akornsys-rdi/acoustic-impact-ball/doc/qrurl.png

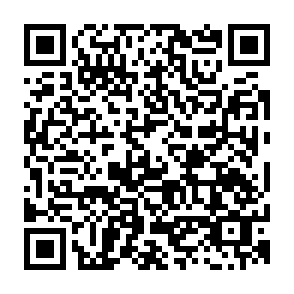
doc/qrurl.png
