akornsys-rdi/acoustic-impact-ball/doc/UN3481.png

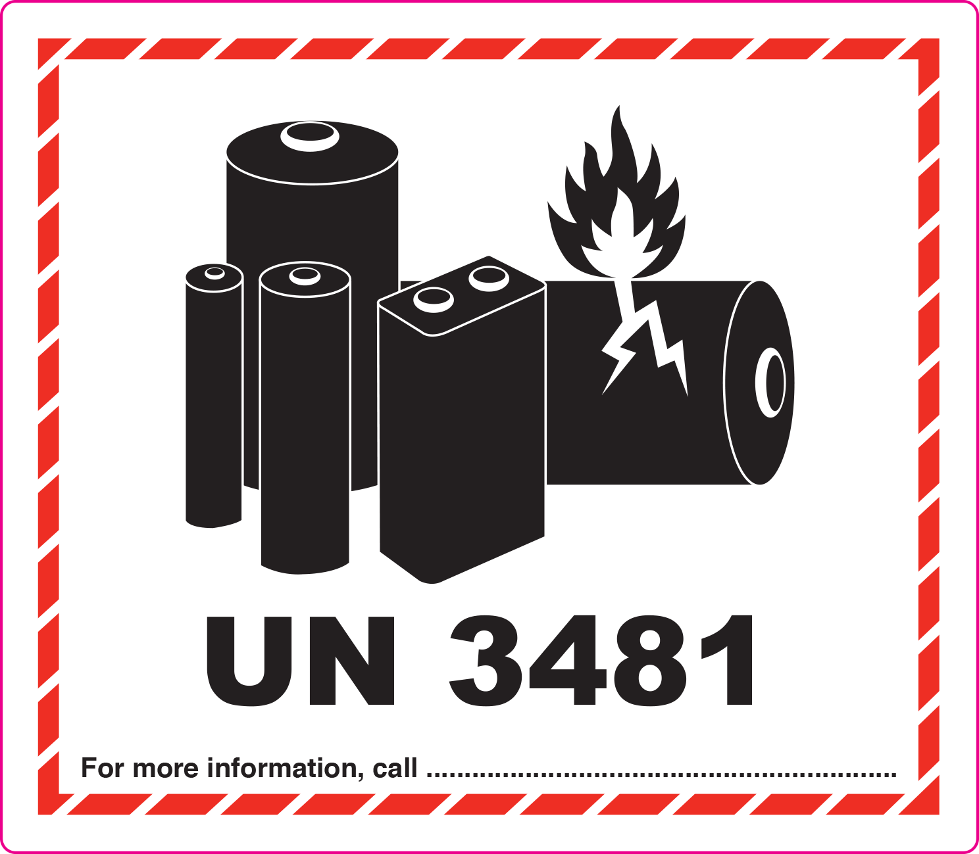
doc/UN3481.png
