akornsys-rdi/acoustic-impact-ball/brd/out/acoustic-impact-ball-bom+cpl.xls

Sheet: BoM
Reference | Value | Footprint | Datasheet | Manufacturer | Manufacturer Part
C1, C25 | 1µF | Capacitor_SMD:C_0805_2012Metric |  | amsung Electro-Mechanics | CL21B105KOFNNNG
C2, C3, C4, C5, C7, C11, C12, C27 | 100nF | Capacitor_SMD:C_0805_2012Metric |  | Kemet | C0805C104M3RAC7210
C6, C8, C19 | 10µF | Capacitor_SMD:C_0805_2012Metric |  | amsung Electro-Mechanics | CL21A106KOQNNNF
C9, C10 | 22pF | Capacitor_SMD:C_0805_2012Metric |  | Kemet | C0805C220K5HACTU
C13, C14, C15, C16, C23, C24 | 22µF | Capacitor_SMD:C_0805_2012Metric |  | Murata | GRM21BR61A226ME44L
C17, C18 | 220pF | Capacitor_SMD:C_0805_2012Metric |  | Kemet | C0805C221M5RACTU
C20 | 150µF | Capacitor_Tantalum_SMD:CP_EIA-7343-31_Kemet-D |  | Kemet | T495D157K010ATE100
C21 | 10nF | Capacitor_SMD:C_0805_2012Metric |  | Kemet | C0805C103K1RAC7210
C22 | 10pF | Capacitor_SMD:C_0805_2012Metric |  | Kemet | C0805C100K5GACTU
C26 | 4.7nF | Capacitor_SMD:C_0805_2012Metric |  | Kemet | C0805C472K5RACTU
D1 | BLUE | LED_SMD:LED_0402_1005Metric | lib/datasheets/150040BS73220.pdf | Wurth Elektronik | 150040BS73220
D2 | RED | LED_SMD:LED_0402_1005Metric | lib/datasheets/APHHS1005SURCK.pdf | Kingbright | APHHS1005SURCK
D3 | GREEN | LED_SMD:LED_0402_1005Metric | lib/datasheets/APHHS1005ZGCK.pdf | Kingbright | APHHS1005ZGCK
D4 | ESD5V5U5ULC | Package_TO_SOT_SMD:SOT-23-6 | lib/datasheets/ESD5V5U5ULC.pdf | Infineon Technologies | ESD5V5U5ULC E6327
F1 | 1.5A | Fuse:Fuse_1206_3216Metric_Castellated | lib/datasheets/0ZCJ.pdf | Bel Fuse | 0ZCJ0150FF2C
J1 | Micro_SD_Card | 5009010801:5009010801 | lib/datasheets/5009010801.pdf | Molex | 500901-0801
J2 | JTAG | Connector_PinHeader_1.27mm:PinHeader_2x05_P1.27mm_Vertical_SMD | lib/datasheets/20021121.pdf | Amphenol FCI | 20021121-00010D4LF
J3 | USB_B_Mini | Connector_USB:USB_Mini-B_Wuerth_65100516121_Horizontal | lib/datasheets/65100516121.pdf | Wurth Elektronik | 65100516121
L1, L2 | Choke | Inductor_SMD:L_0805_2012Metric | lib/datasheets/LSM01.pdf | Taiyo Yuden | FBMH2012HM331-T
L3 | 1µH | Inductor_SMD:L_Wuerth_MAPI-4020 | lib/datasheets/74438356010.pdf | Wurth Elektronik | 74438356010
Q1, Q2 | CSD16301Q2 | Package_SON:Texas_DQK | lib/datasheets/CSD16301Q2.pdf | Texas Instruments | CSD16301Q2
R1, R2 | 10k | Resistor_SMD:R_0805_2012Metric |  | Yageo | RC0805JR-0710KL
R3, R5, R7 | 120R | Resistor_SMD:R_0805_2012Metric |  | Yageo | RC0805JR-07120RL
R4, R11, R13 | 100k | Resistor_SMD:R_0805_2012Metric |  | Yageo | RC0805FR-07100KL
R6 | 316k | Resistor_SMD:R_0805_2012Metric |  | Yageo | RC0805FR-07316KL
R8 | 2k | Resistor_SMD:R_0805_2012Metric |  | Yageo | RC0805JR-072KL
R9 | 1k | Resistor_SMD:R_0805_2012Metric |  | Yageo | RC0805JR-071KL
R10 | 95k3 | Resistor_SMD:R_0805_2012Metric |  | Yageo | RC0805FR-0795K3L
R12 | 1M | Resistor_SMD:R_0805_2012Metric |  | Yageo | RC0805JR-071ML
R14 | 330R | Resistor_SMD:R_0805_2012Metric |  | Yageo | RC0805JR-07330RL
R15 | 2k2 | Resistor_SMD:R_0805_2012Metric |  | Yageo | RC0805JR-072K2L
R16, R17 | 5M1 | Resistor_SMD:R_0805_2012Metric |  | Yageo | RC0805JR-075M1L
SW1 | Reset | EVQP7:EVQP7 | lib/datasheets/EVQ.pdf | Panasonic | EVQ-P7L01P
SW2 | SW_SPDT | Button_Switch_SMD:SW_SPDT_PCM12 | lib/datasheets/MSS34.pdf | Diptronics | MSS3-V-T/R
U1 | LIS3DH | Package_LGA:LGA-16_3x3mm_P0.5mm_LayoutBorder3x5y | lib/datasheets/LIS3DH.pdf | STMicroelectronics | LIS3DHTR
U2 | ATSAMD21G18A-AU | Package_QFP:TQFP-48_7x7mm_P0.5mm | lib/datasheets/ATSAM-D21.pdf | Microchip Technology | ATSAMD21G18A-AU
U3 | MAX98357 | Package_DFN_QFN:QFN-16-1EP_3x3mm_P0.5mm_EP1.45x1.45mm_ThermalVias | lib/datasheets/MAX98357.pdf | Analog Devices | MAX98357AETE+T
U4 | MCP73831-2-OT | Package_TO_SOT_SMD:SOT-23-5 | lib/datasheets/MCP73831.pdf | Microchip Technology | MCP73831T-2ACI/OT
U5 | MIC5201 | Package_TO_SOT_SMD:SOT-223-3_TabPin2 | lib/datasheets/MIC5201.pdf | Microchip Technology | MIC5201-3.3YS-TR
U6 | TPS61230A | TPS61230A:TPS61230A | lib/datasheets/TPS61230A.pdf | Texas Instruments | TPS61230ARNSR
U7 | BQ297xy | Package_SON:WSON-6_1.5x1.5mm_P0.5mm | lib/datasheets/BQ2970.pdf | Texas Instruments | BQ29700DSER
Y1 | 32.768kHz | Crystal:Crystal_SMD_3215-2Pin_3.2x1.5mm | lib/datasheets/FC-135.pdf | Epson | FC-135 32.7680KA-A5

Sheet: CPL
Ref | PosX | PosY | Rot | Side
C1 | 18.796000 | -18.542000 | 0.000000 | top
C2 | 18.542000 | -35.560000 | 0.000000 | top
C3 | 11.684000 | -29.718000 | 90.000000 | top
C4 | 26.162000 | -25.400000 | 270.000000 | top
C5 | 18.796000 | -20.828000 | 0.000000 | top
C6 | 15.748000 | -19.558000 | 90.000000 | top
C7 | 29.464000 | -6.096000 | 90.000000 | top
C8 | 31.750000 | -6.096000 | 90.000000 | top
C9 | 8.382000 | -24.384000 | 0.000000 | top
C10 | 8.382000 | -26.924000 | 0.000000 | top
C11 | 10.668000 | -40.894000 | 0.000000 | top
C12 | 19.304000 | -51.562000 | 90.000000 | top
C13 | 23.876000 | -54.864000 | 0.000000 | top
C14 | 20.066000 | -54.864000 | 180.000000 | top
C15 | 20.066000 | -57.404000 | 180.000000 | top
C16 | 23.876000 | -57.404000 | 0.000000 | top
C17 | 27.686000 | -54.864000 | 180.000000 | top
C18 | 27.686000 | -47.244000 | 180.000000 | top
C19 | 30.734000 | -72.136000 | 90.000000 | top
C20 | 28.702000 | -76.962000 | 0.000000 | top
C21 | 19.558000 | -64.262000 | 180.000000 | top
C22 | 23.876000 | -64.262000 | 180.000000 | top
C23 | 16.510000 | -66.802000 | 270.000000 | top
C24 | 14.224000 | -66.802000 | 270.000000 | top
C25 | 4.572000 | -65.786000 | 270.000000 | top
C26 | 11.684000 | -87.630000 | 90.000000 | top
C27 | 10.414000 | -3.810000 | 270.000000 | top
D1 | 26.924000 | -88.392000 | 90.000000 | top
D2 | 25.654000 | -88.392000 | 90.000000 | top
D3 | 9.144000 | -88.392000 | 0.000000 | top
D4 | 13.208000 | -77.724000 | 90.000000 | top
F1 | 22.606000 | -74.676000 | 270.000000 | top
J1 | 9.652000 | -48.768000 | 90.000000 | top
J2 | 19.050000 | -12.192000 | 180.000000 | top
J3 | 19.000000 | -85.184000 | 0.000000 | top
L1 | 27.686000 | -52.324000 | 0.000000 | top
L2 | 27.686000 | -49.784000 | 0.000000 | top
L3 | 19.050000 | -71.628000 | 90.000000 | top
Q1 | 10.160000 | -7.620000 | 90.000000 | top
Q2 | 7.112000 | -7.620000 | 270.000000 | top
R1 | 30.480000 | -13.462000 | 180.000000 | top
R2 | 30.480000 | -15.748000 | 180.000000 | top
R3 | 28.448000 | -82.804000 | 90.000000 | top
R4 | 19.304000 | -47.752000 | 90.000000 | top
R5 | 26.162000 | -82.804000 | 270.000000 | top
R6 | 23.876000 | -66.548000 | 180.000000 | top
R7 | 9.144000 | -85.344000 | 270.000000 | top
R8 | 27.686000 | -68.834000 | 180.000000 | top
R9 | 23.876000 | -61.976000 | 0.000000 | top
R10 | 23.876000 | -68.834000 | 0.000000 | top
R11 | 35.814000 | -82.804000 | 90.000000 | top
R12 | 11.684000 | -83.820000 | 270.000000 | top
R13 | 35.814000 | -78.994000 | 90.000000 | top
R14 | 13.462000 | -2.286000 | 180.000000 | top
R15 | 7.366000 | -2.286000 | 180.000000 | top
R16 | 12.700000 | -7.620000 | 270.000000 | top
R17 | 4.572000 | -7.620000 | 270.000000 | top
SW1 | 4.572000 | -86.360000 | 180.000000 | top
SW2 | 32.512000 | -87.724000 | 0.000000 | top
U1 | 30.637000 | -10.087000 | 0.000000 | top
U2 | 19.050000 | -28.194000 | 0.000000 | top
U3 | 23.114000 | -50.292000 | 0.000000 | top
U4 | 27.432000 | -72.136000 | 0.000000 | top
U5 | 9.398000 | -67.818000 | 270.000000 | top
U6 | 19.573000 | -67.310000 | 270.000000 | top
U7 | 7.874000 | -4.572000 | 0.000000 | top
Y1 | 11.684000 | -25.654000 | 90.000000 | top
