akornsys-rdi/acoustic-impact-ball/3d/ring.stl

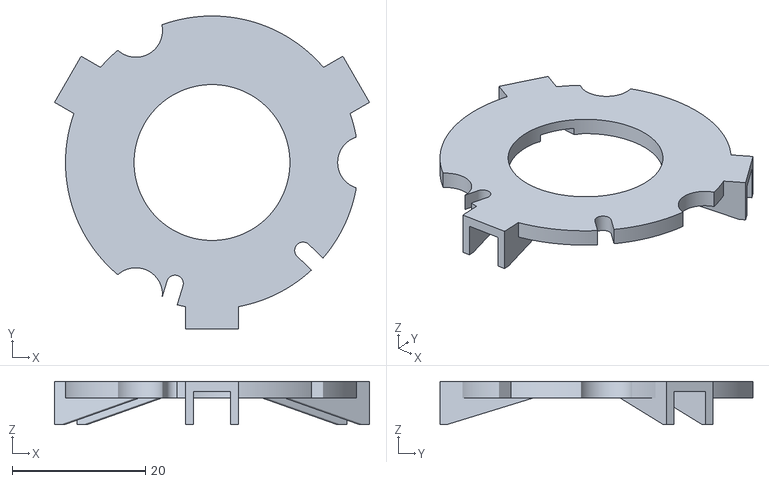
[picture p3: CAD file, 2023-10-07]
3d/ring.stl
47.3 x 47.0 x 6.50
