akornsys-rdi/acoustic-impact-ball/3d/switch-fastening_sup.stl

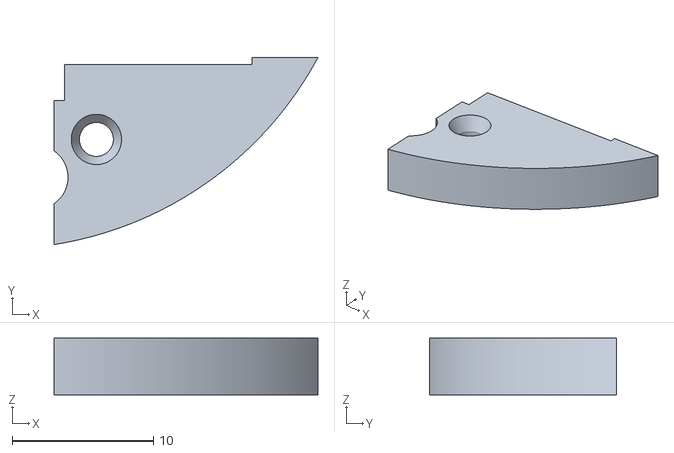
[picture p4: CAD file, 2023-10-07]
3d/switch-fastening_sup.stl
18.7 x 13.2 x 4.00
