akornsys-rdi/acoustic-impact-ball/3d/switch-handler.stl

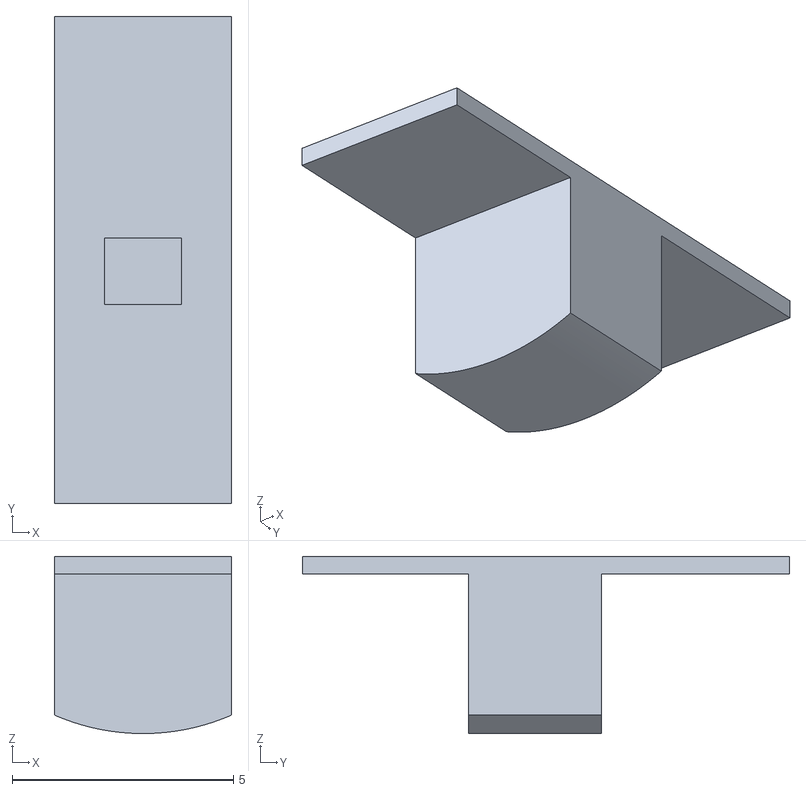
[picture p5: CAD file, 2023-10-07]
3d/switch-handler.stl
4.00 x 11.0 x 4.00
