akornsys-rdi/acoustic-impact-ball/3d/switch-fastening_inf.stl

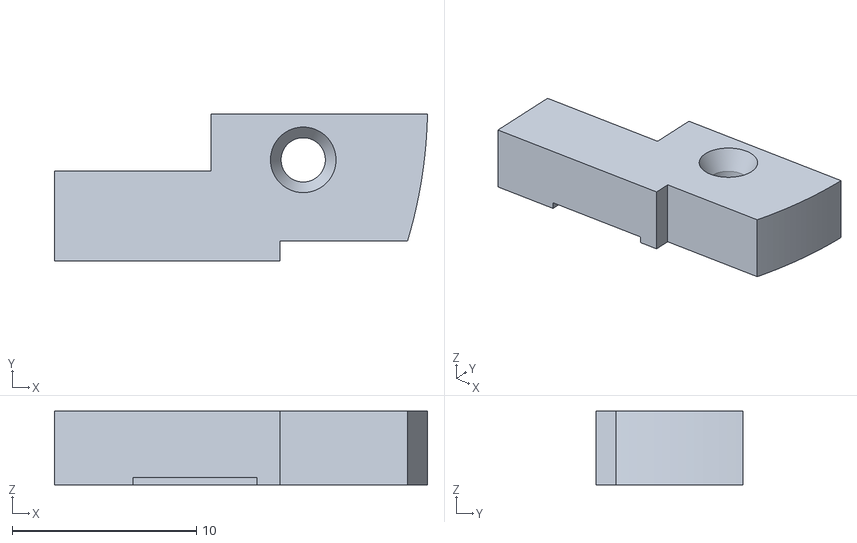
[picture p6: CAD file, 2023-10-07]
3d/switch-fastening_inf.stl
20.2 x 8.00 x 4.00
