akornsys-rdi/acoustic-impact-ball/3d/lid.stl

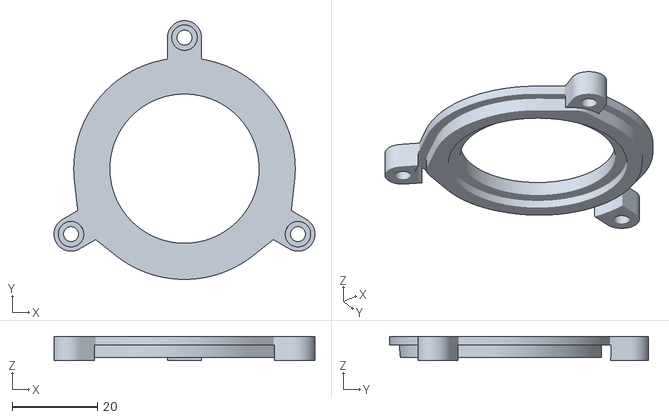
[picture p7: CAD file, 2020-08-20]
3d/lid.stl
61.3 x 60.8 x 5.75
