akornsys-rdi/acoustic-impact-ball/doc/acoustic-impact-ball-special-1-2.pdf

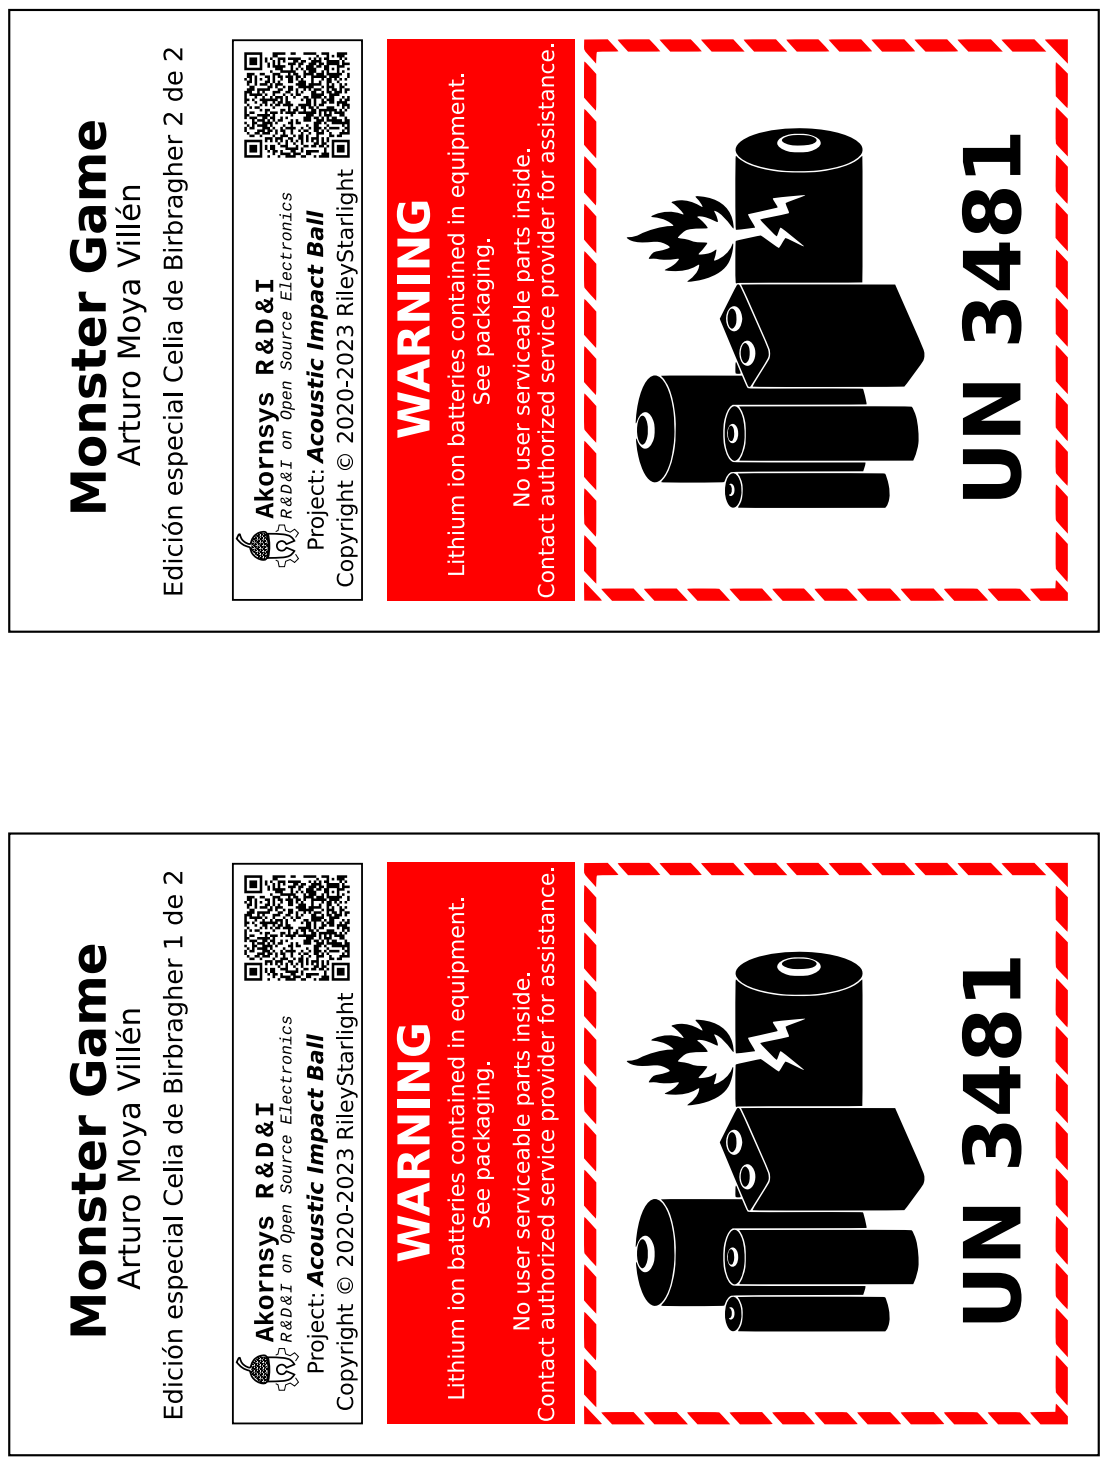
[picture p8: page 1]
