akornsys-rdi/acoustic-impact-ball/doc/acoustic-impact-ball-page-1-2.pdf

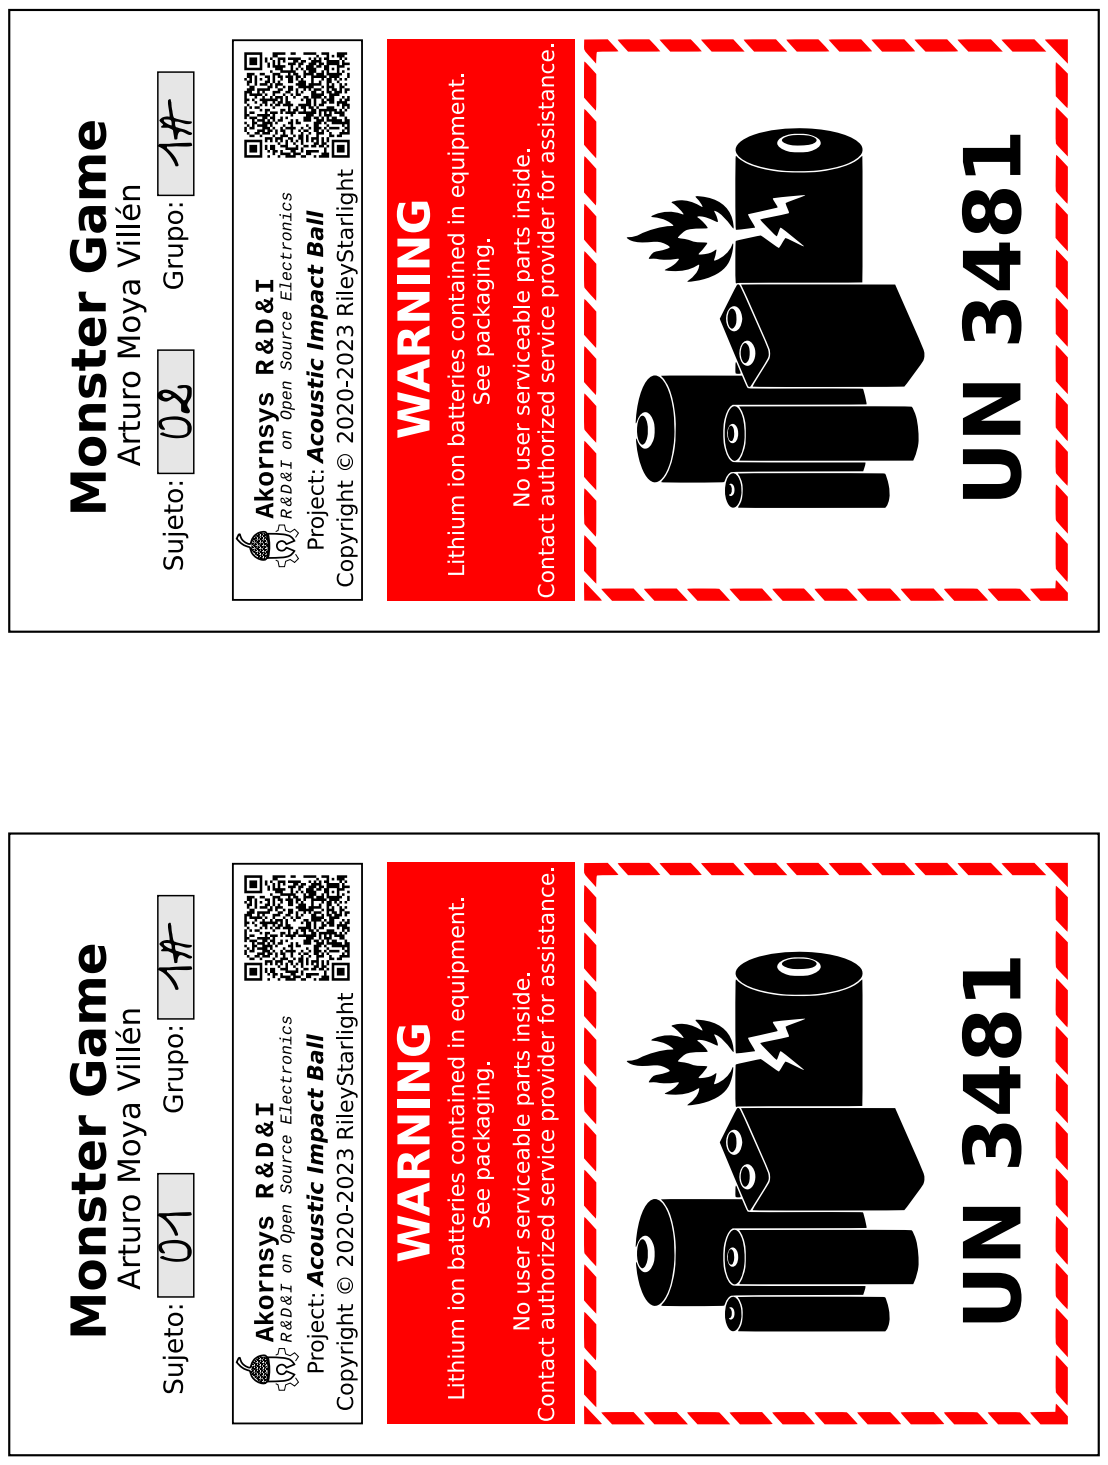
[picture p9: page 1]
