akornsys-rdi/acoustic-impact-ball/doc/acoustic-impact-ball-page-1-22.pdf

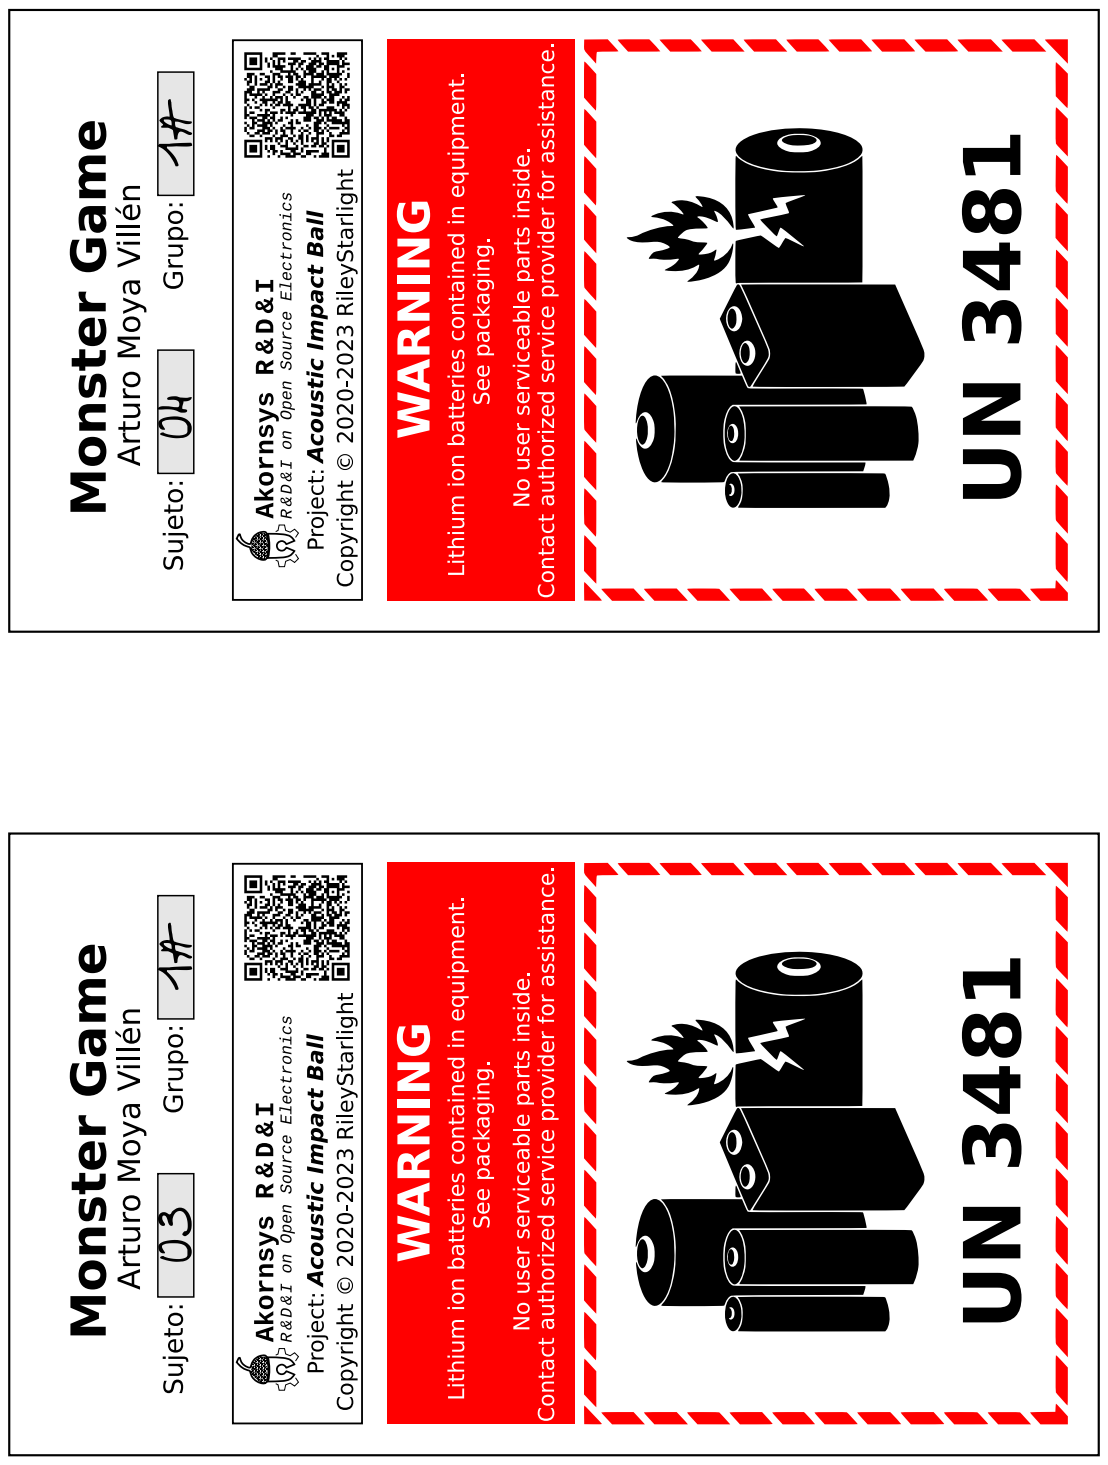
[picture p10: page 2]

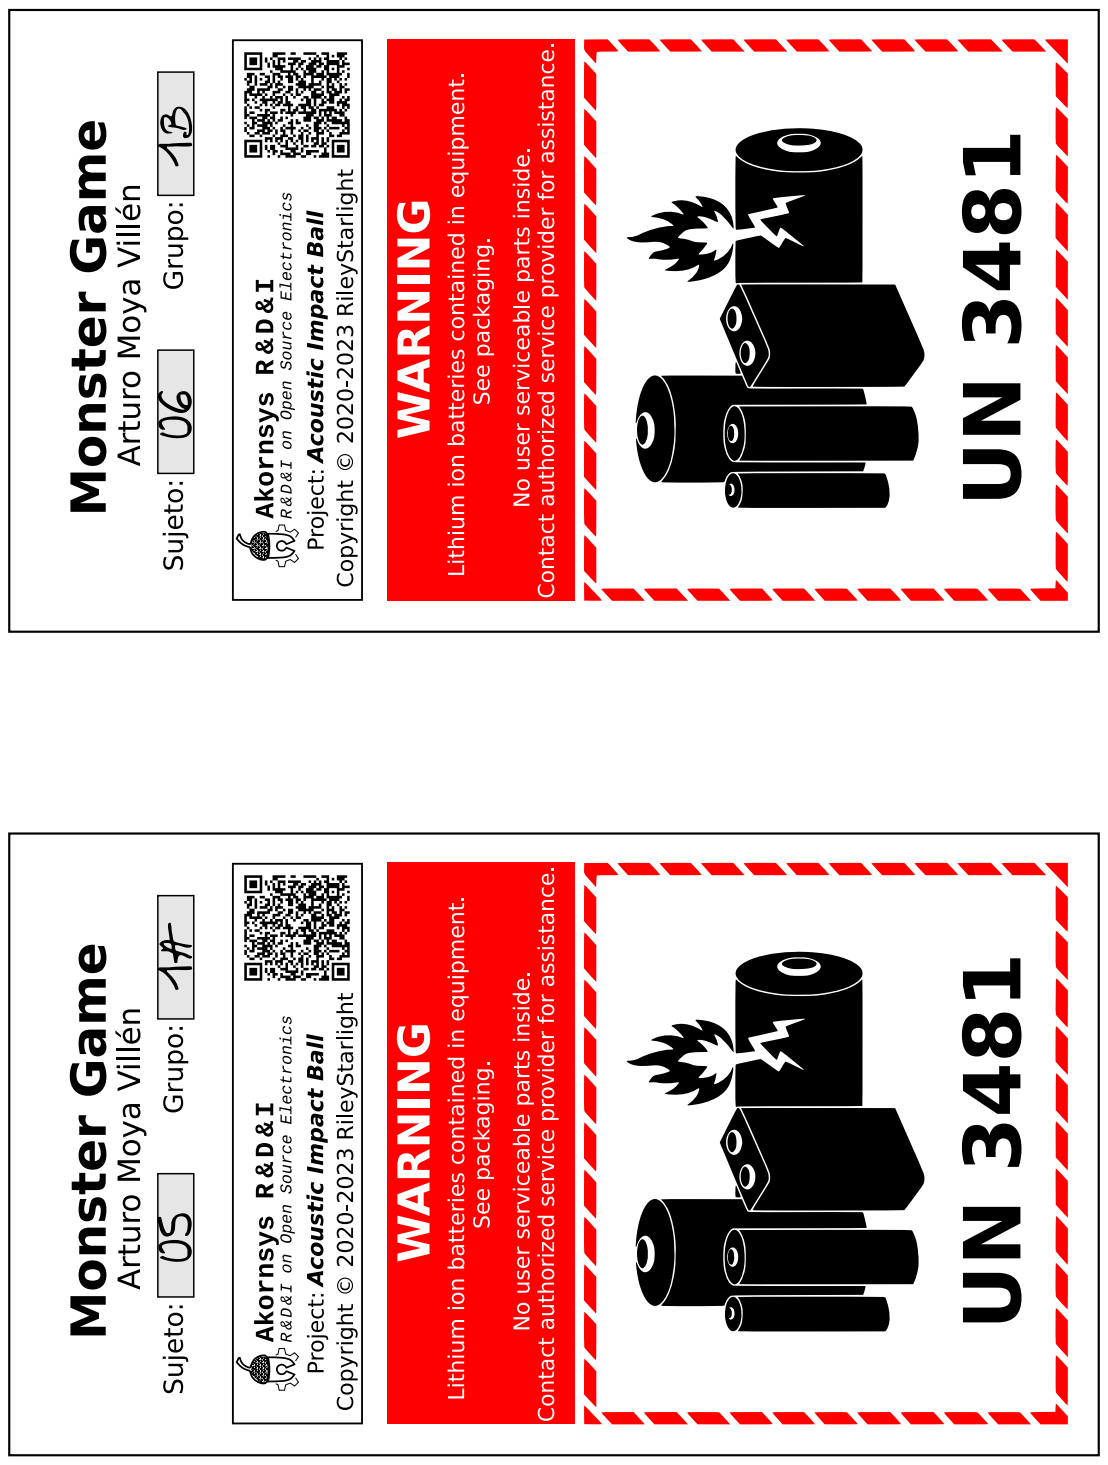
[picture p11: page 3]

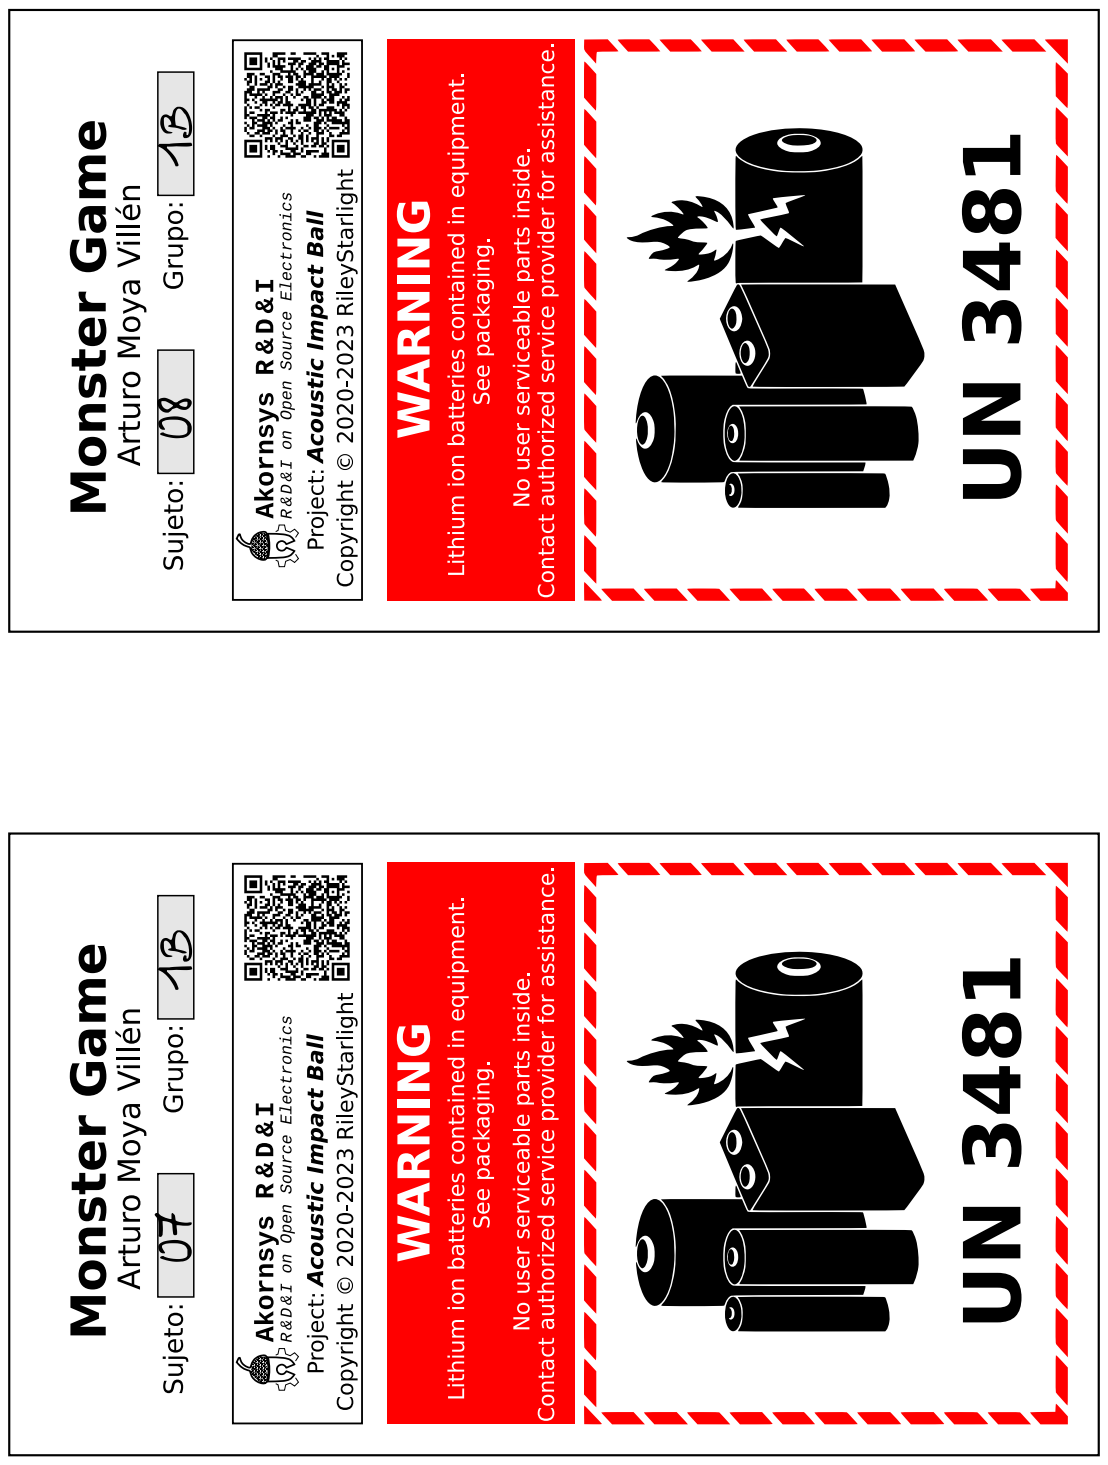
[picture p12: page 4]

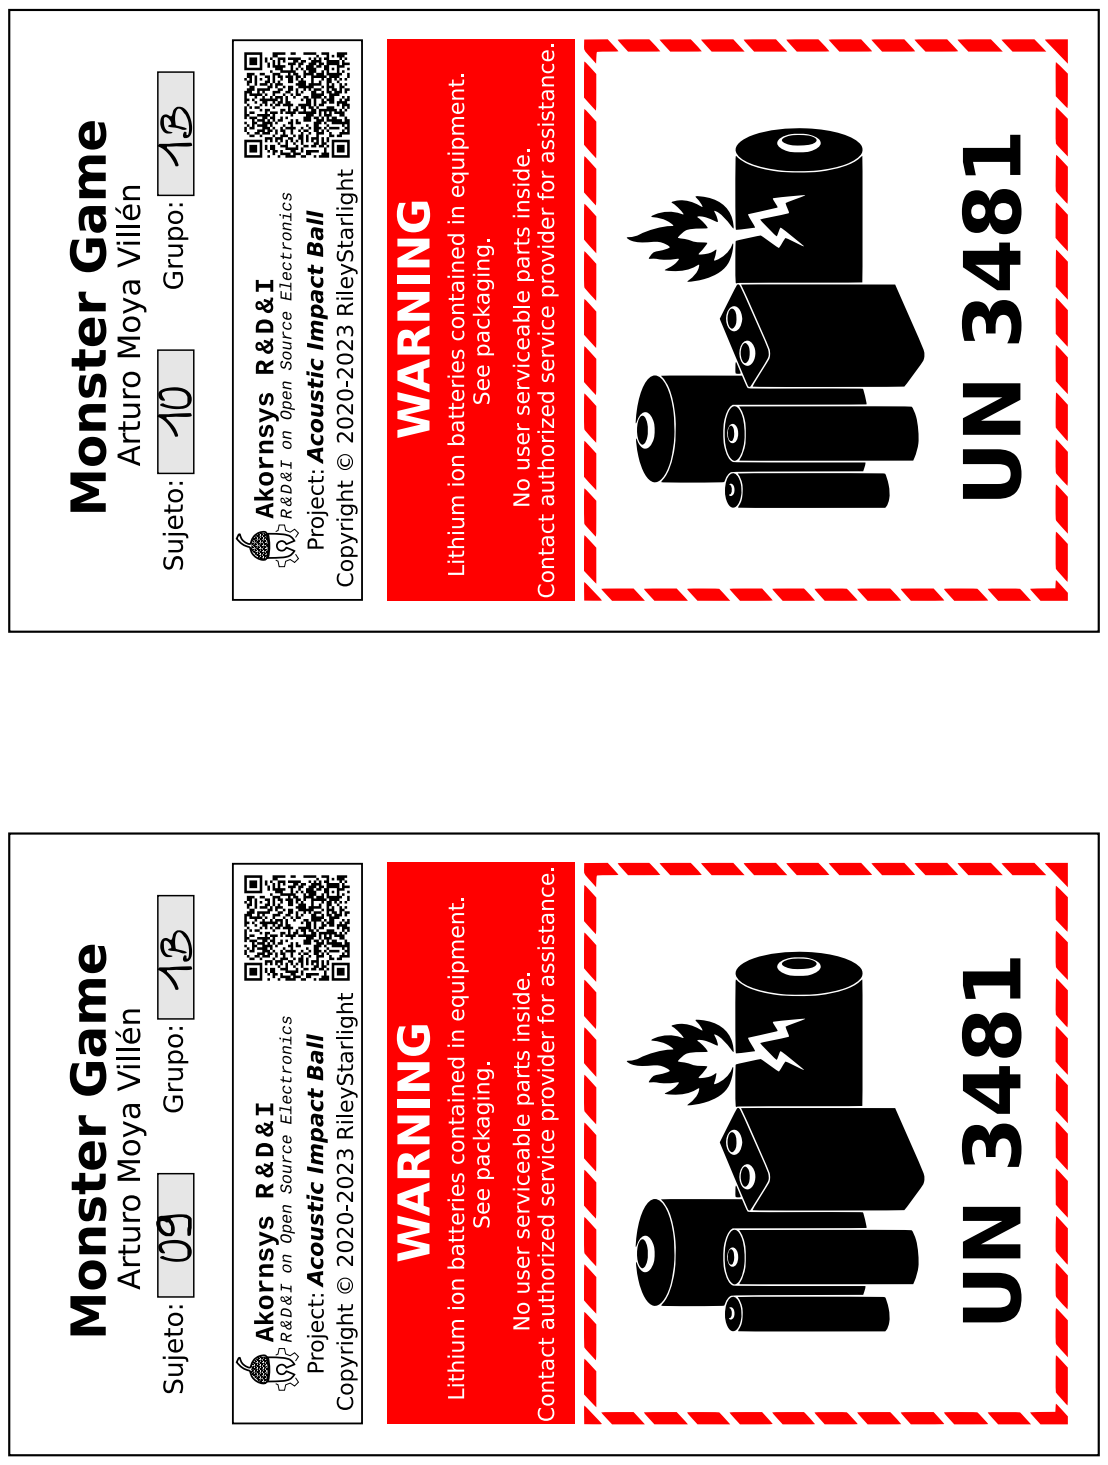
[picture p13: page 5]

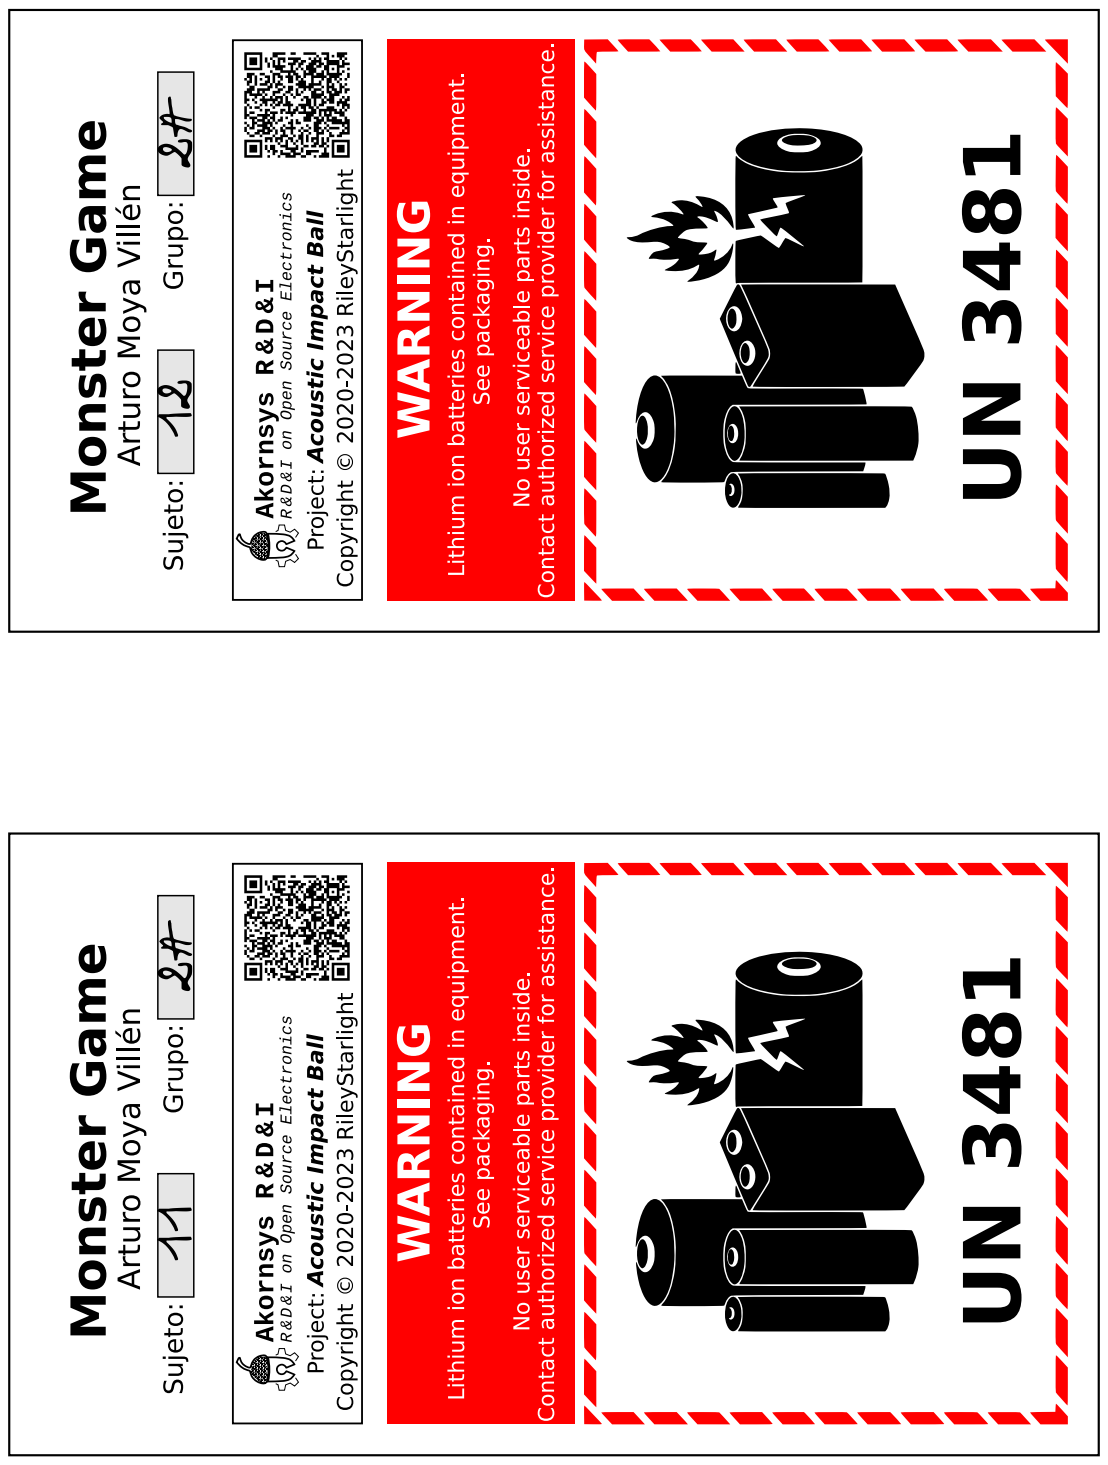
[picture p14: page 6]

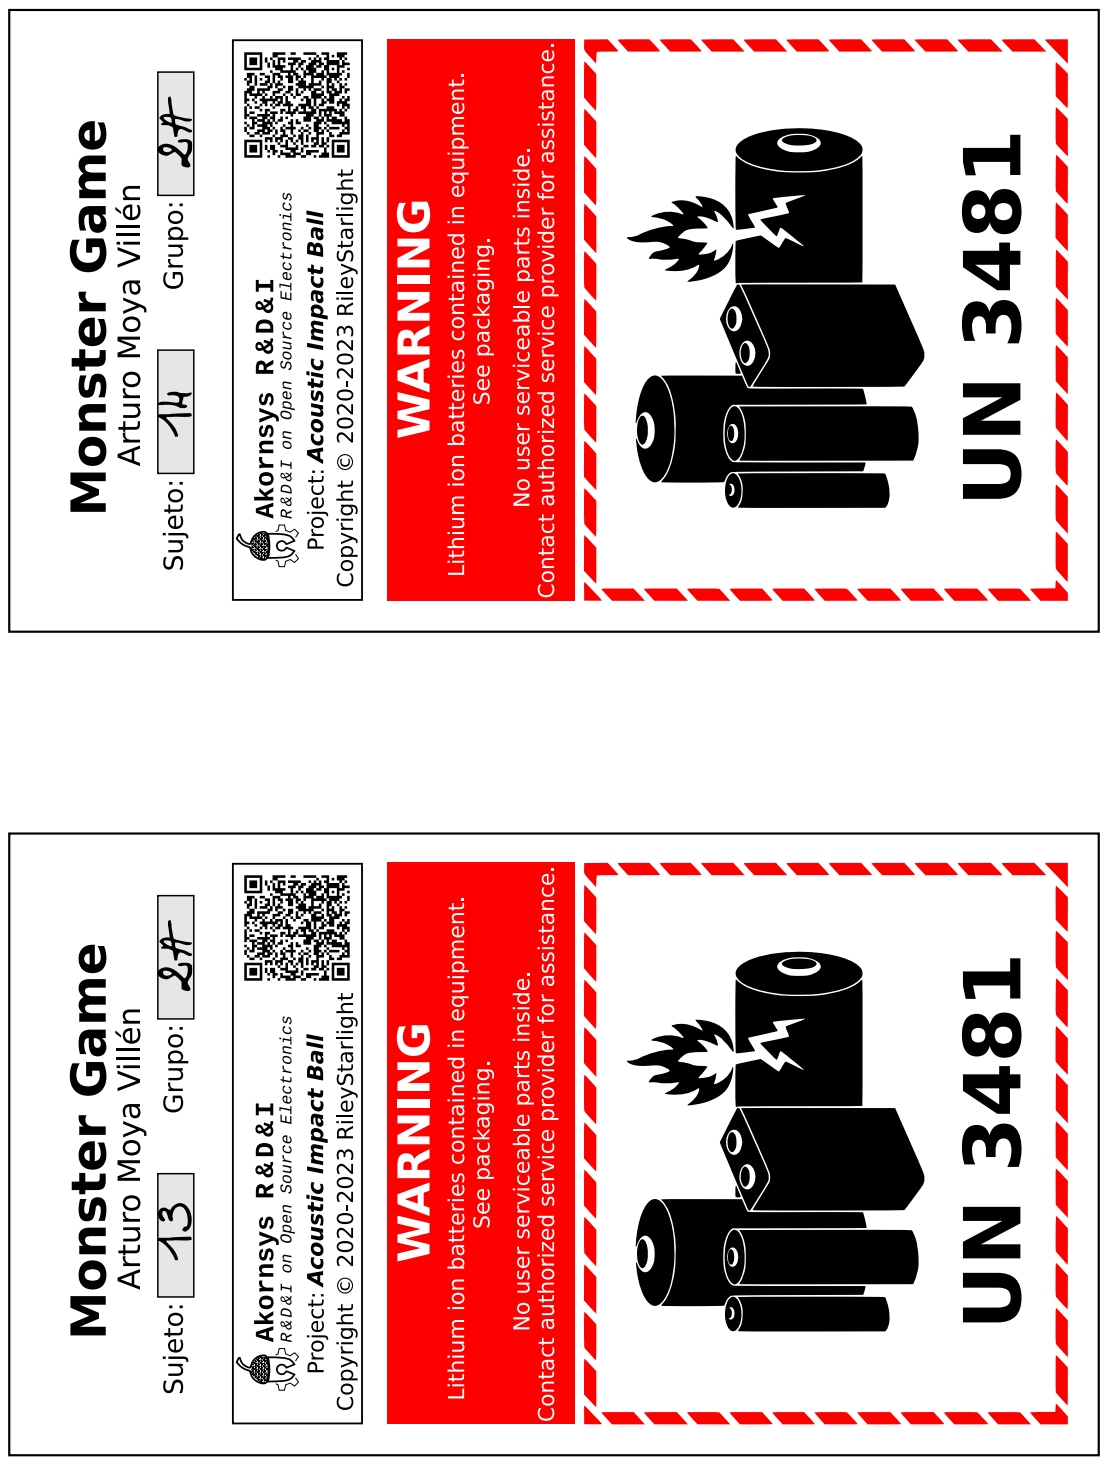
[picture p15: page 7]

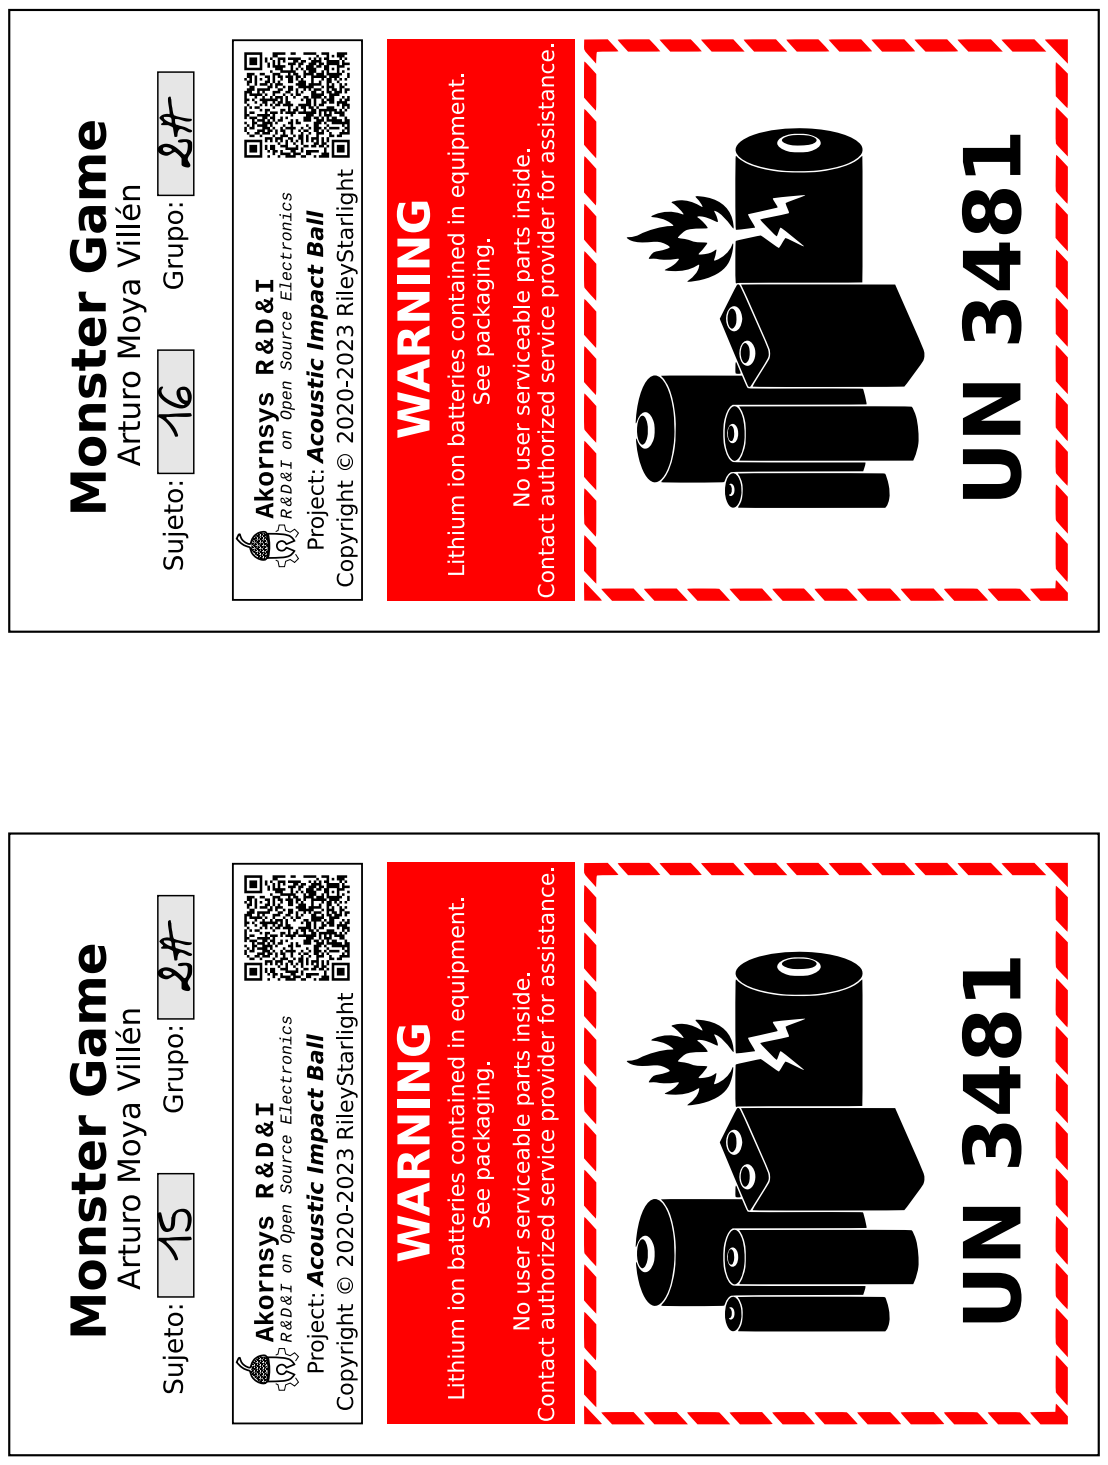
[picture p16: page 8]

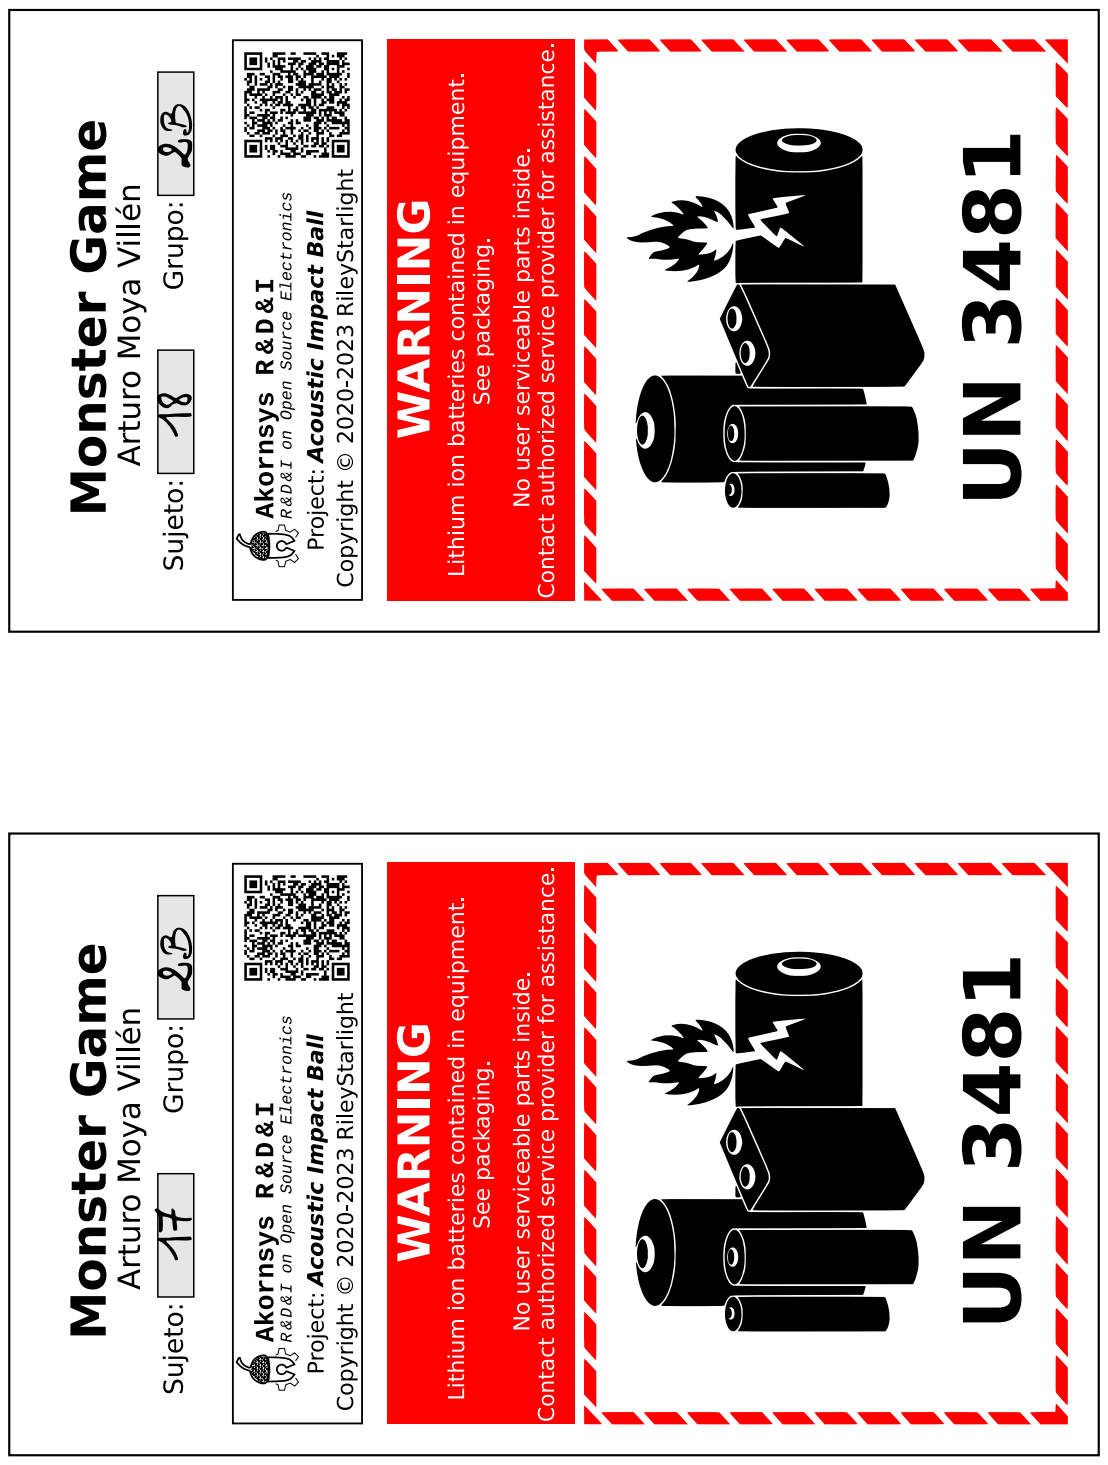
[picture p17: page 9]

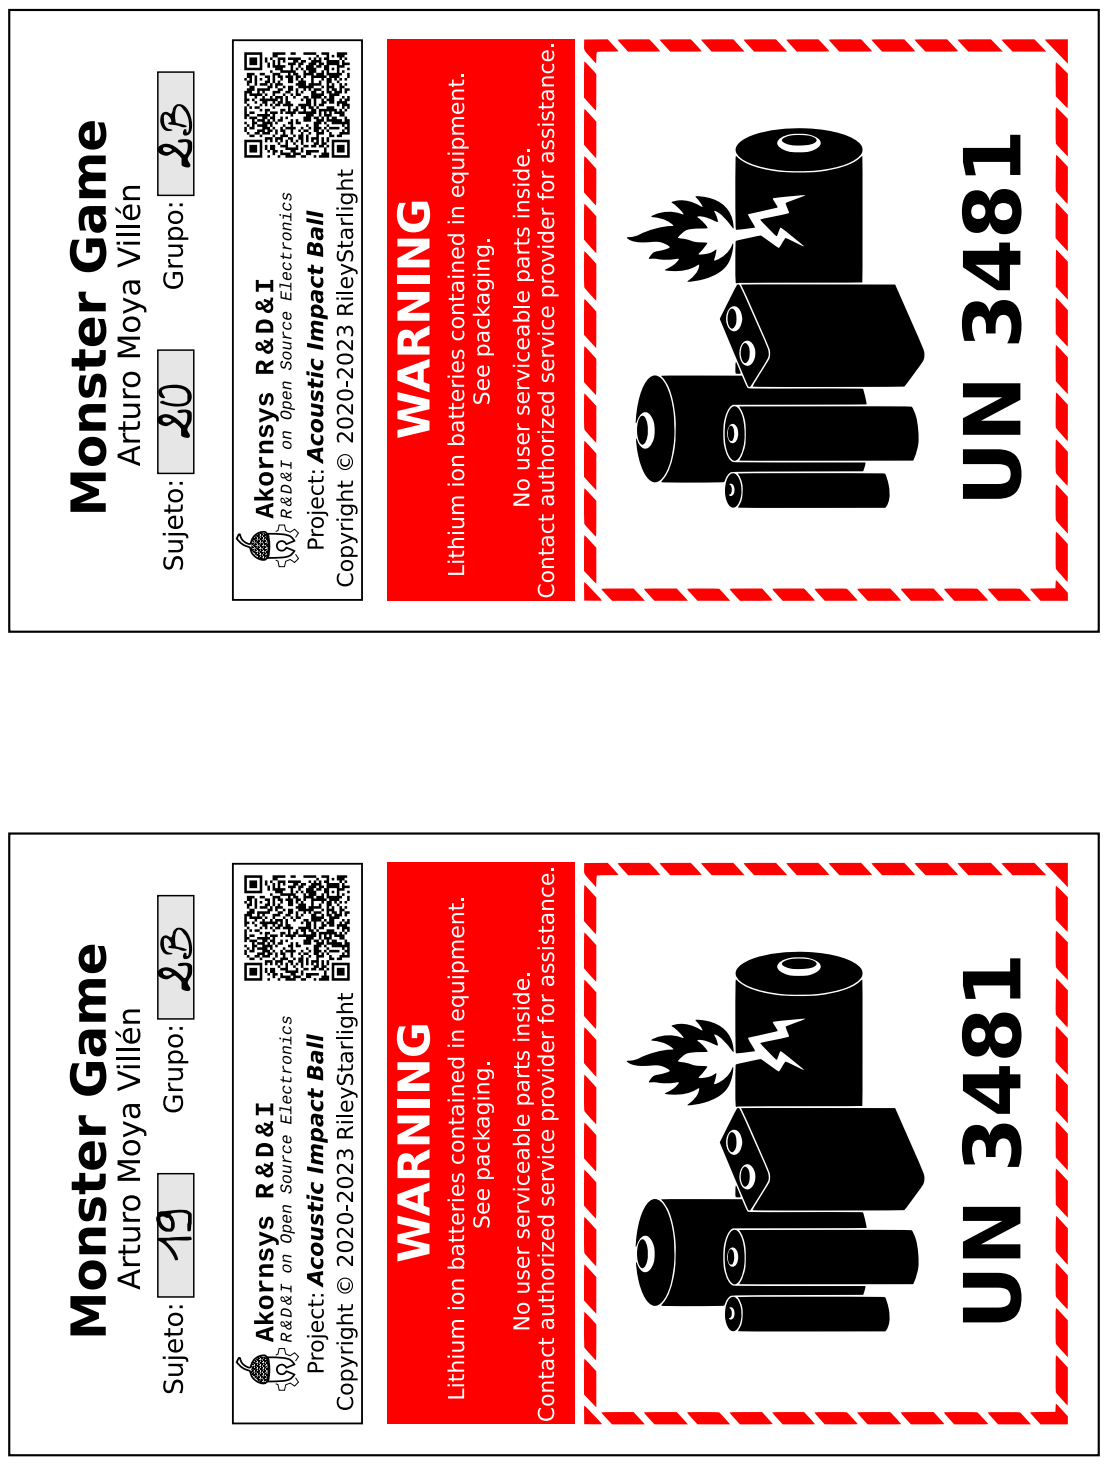
[picture p18: page 10]

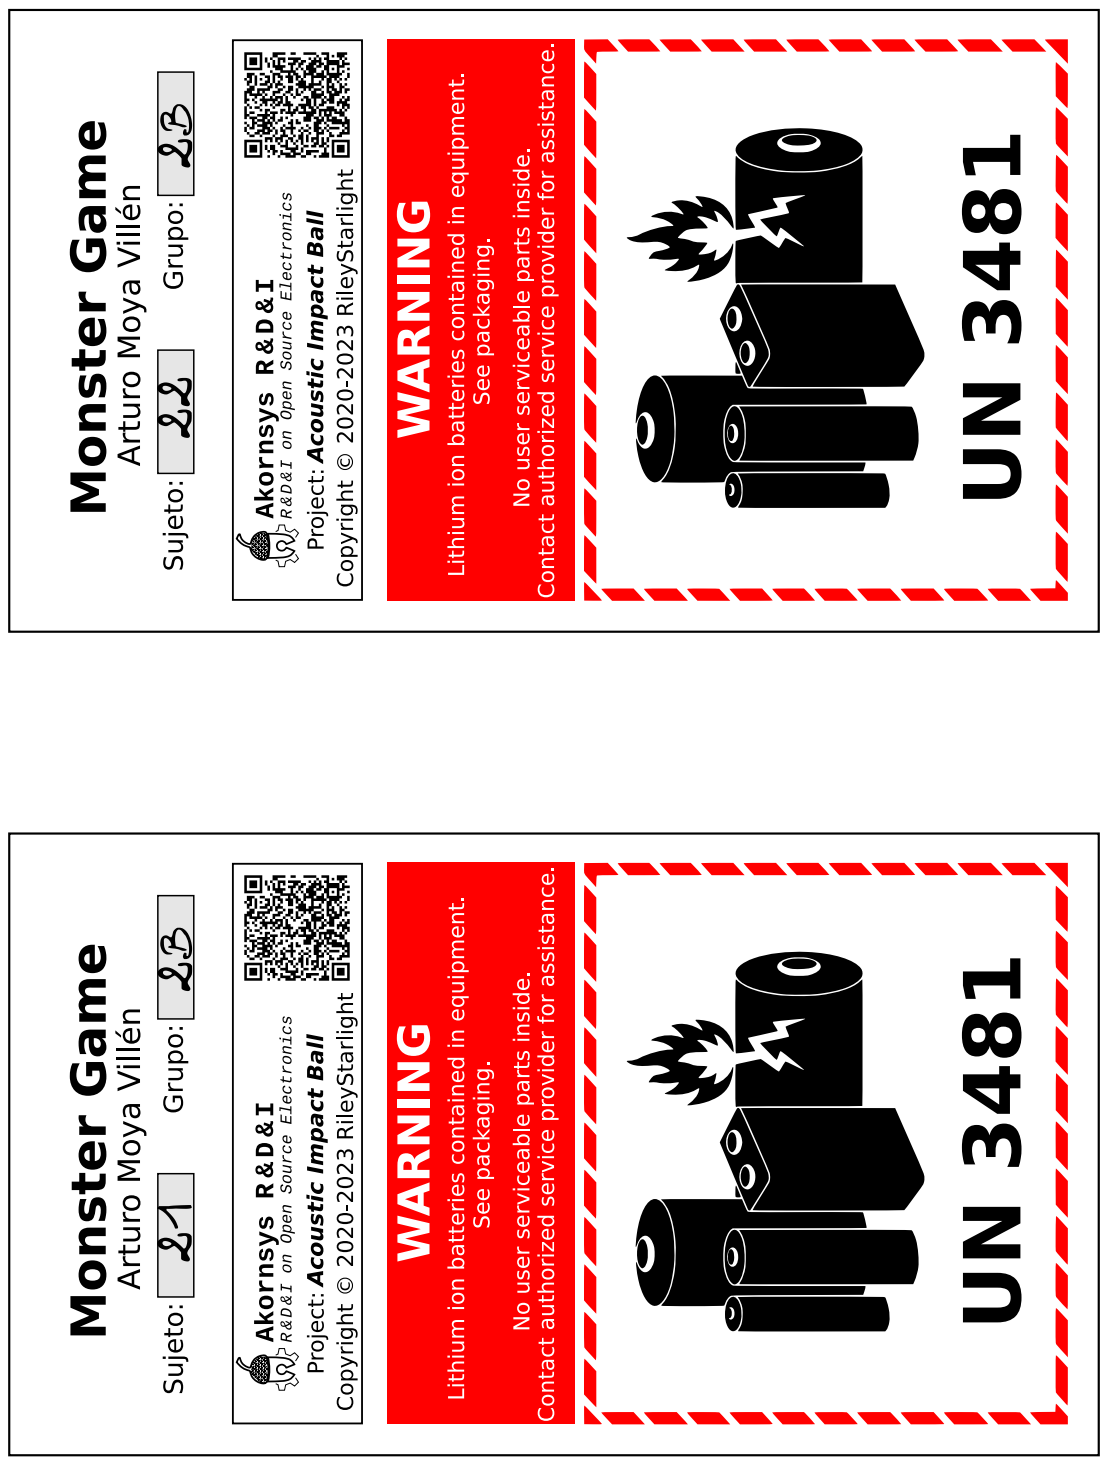
[picture p19: page 11]
