akornsys-rdi/acoustic-impact-ball/brd/acoustic-impact-ball.kicad_pcb

## KiCad design brd/acoustic-impact-ball.kicad_pcb (2023-10-07)

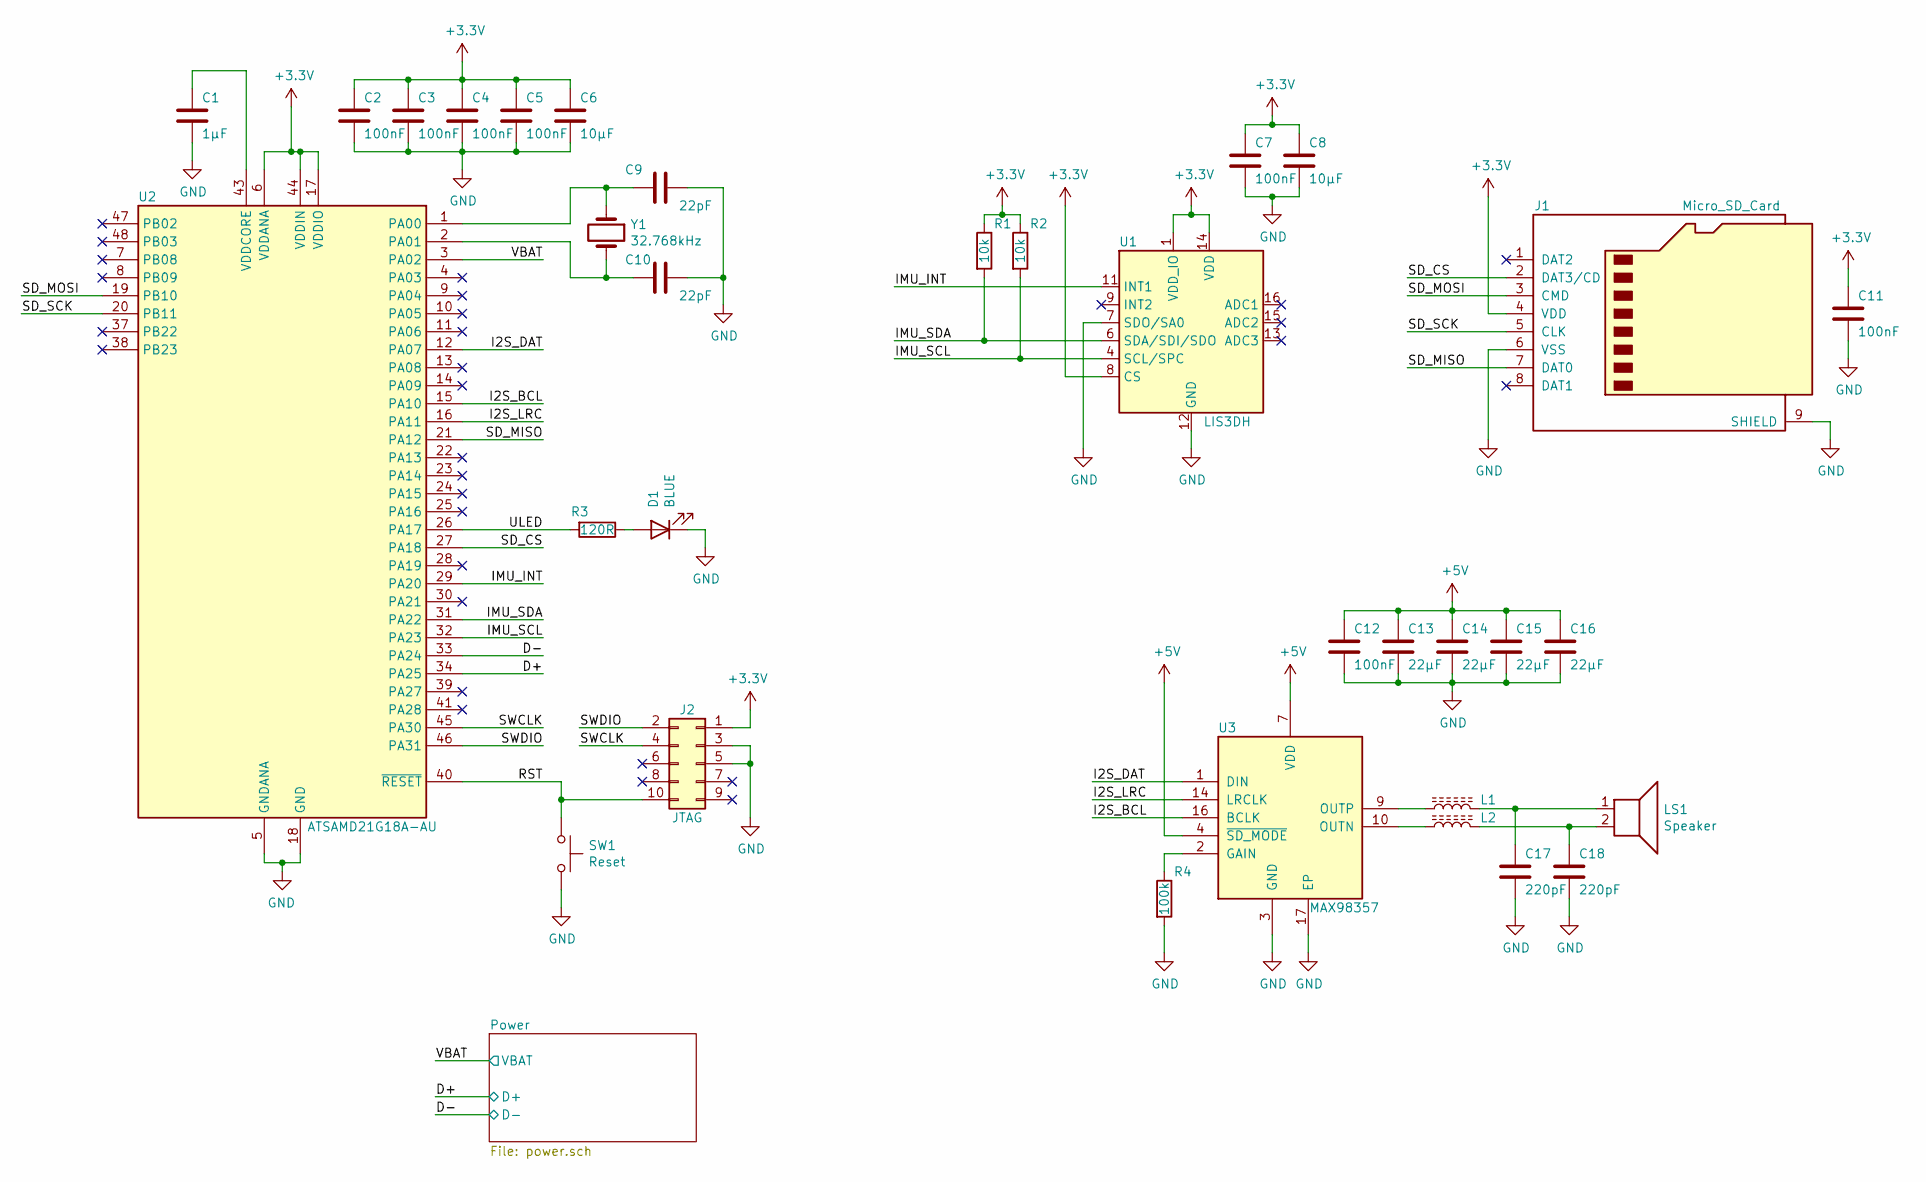
[picture p20: schematic acoustic-impact-ball.sch]

Parts:
C1: 1µF; C_0805_2012Metric; Manufacturer Part Number CL21B105KOFNNNG
C2, C3, C4, C5, C7, C11, C12: 100nF; C_0805_2012Metric; Manufacturer Part Number C0805C104M3RAC7210
C6, C8: 10µF; C_0805_2012Metric; Manufacturer Part Number CL21A106KOQNNNF
C9, C10: 22pF; C_0805_2012Metric; Manufacturer Part Number C0805C220K5HACTU
C13, C14, C15, C16: 22µF; C_0805_2012Metric; Manufacturer Part Number GRM21BR61A226ME44L
C17, C18: 220pF; C_0805_2012Metric; Manufacturer Part Number C0805C221M5RACTU
D1: BLUE; LED_0402_1005Metric; Manufacturer Part Number 150040BS73220
J1: Micro_SD_Card; 5009010801; Manufacturer Part Number 500901-0801
J2: JTAG; PinHeader_2x05_P1.27mm_Vertical_SMD; Manufacturer Part Number 20021121-00010D4LF
L1, L2: Choke; L_0805_2012Metric; Manufacturer Part Number FBMH2012HM331-T
LS1: Speaker; PinHeader_1x02_P2.54mm_Horizontal; Manufacturer Part Number 10129379-902001BLF
R1, R2: 10k; R_0805_2012Metric; Manufacturer Part Number RC0805JR-0710KL
R3: 120R; R_0805_2012Metric; Manufacturer Part Number RC0805JR-07120RL
R4: 100k; R_0805_2012Metric; Manufacturer Part Number RC0805FR-07100KL
SW1: Reset; EVQP7; Manufacturer Part Number EVQ-P7L01P
U1: LIS3DH; LGA-16_3x3mm_P0.5mm_LayoutBorder3x5y; Manufacturer Part Number LIS3DHTR
U2: ATSAMD21G18A-AU; TQFP-48_7x7mm_P0.5mm; Manufacturer Part Number ATSAMD21G18A-AU
U3: MAX98357; QFN-16-1EP_3x3mm_P0.5mm_EP1.45x1.45mm_ThermalVias; Manufacturer Part Number MAX98357AETE+T
Y1: 32.768kHz; Crystal_SMD_3215-2Pin_3.2x1.5mm; Manufacturer Part Number FC-135 32.7680KA-A5

Connections:
+3V3: C2.1, C3.1, C4.1, C5.1, C6.1, C7.1, C8.1, C11.1, J1.4 (VDD), J2.1, R1.1, R2.1, U1.1 (VDD_IO), U1.8 (CS), U1.14 (VDD), U2.6 (VDDANA), U2.17 (VDDIO), U2.36 (VDDIO), U2.44 (VDDIN); also elsewhere on the board
+5V: C12.1, C13.1, C14.1, C15.1, C16.1, U3.4 (~SD_MODE), U3.7 (VDD), U3.8 (VDD); also elsewhere on the board
/D+: U2.34 (PA25); also elsewhere on the board
/D-: U2.33 (PA24); also elsewhere on the board
/I2S_BCL: U2.15 (PA10), U3.16 (BCLK)
/I2S_DAT: U2.12 (PA07), U3.1 (DIN)
/I2S_LRC: U2.16 (PA11), U3.14 (LRCLK)
/IMU_INT: U1.11 (INT1), U2.29 (PA20)
/IMU_SCL: R2.2, U1.4 (SCL/SPC), U2.32 (PA23)
/IMU_SDA: R1.2, U1.6 (SDA/SDI/SDO), U2.31 (PA22)
/RST: J2.10, SW1.1, U2.40 (~RESET)
/SD_CS: J1.2 (DAT3/CD), U2.27 (PA18)
/SD_MISO: J1.7 (DAT0), U2.21 (PA12)
/SD_MOSI: J1.3 (CMD), U2.19 (PB10)
/SD_SCK: J1.5 (CLK), U2.20 (PB11)
/SWCLK: J2.4, U2.45 (PA30)
/SWDIO: J2.2, U2.46 (PA31)
/ULED: R3.2, U2.26 (PA17)
/VBAT: U2.3 (PA02); also elsewhere on the board
GND: C1.2, C2.2, C3.2, C4.2, C5.2, C6.2, C7.2, C8.2, C9.1, C10.1, C11.2, C12.2, C13.2, C14.2, C15.2, C16.2, C17.2, C18.2, D1.1 (K), J1.6 (VSS), J1.9 (SHIELD), J2.3, J2.5, R4.2, SW1.2, U1.5 (GND), U1.7 (SDO/SA0), U1.10 (GND), U1.12 (GND), U2.5 (GNDANA), U2.18 (GND), U2.35 (GND), U2.42 (GND), U3.3 (GND), U3.11 (GND), U3.15 (GND), U3.17 (EP); also elsewhere on the board
unnamed: C1.1, U2.43 (VDDCORE)
unnamed: C9.2, U2.1 (PA00), Y1.1
unnamed: C10.2, U2.2 (PA01), Y1.2
unnamed: C17.1, L1.2, LS1.1
unnamed: C18.1, L2.2, LS1.2
unnamed: D1.2 (A), R3.1
unnamed: L1.1, U3.9 (OUTP)
unnamed: L2.1, U3.10 (OUTN)
unnamed: R4.1, U3.2 (GAIN)

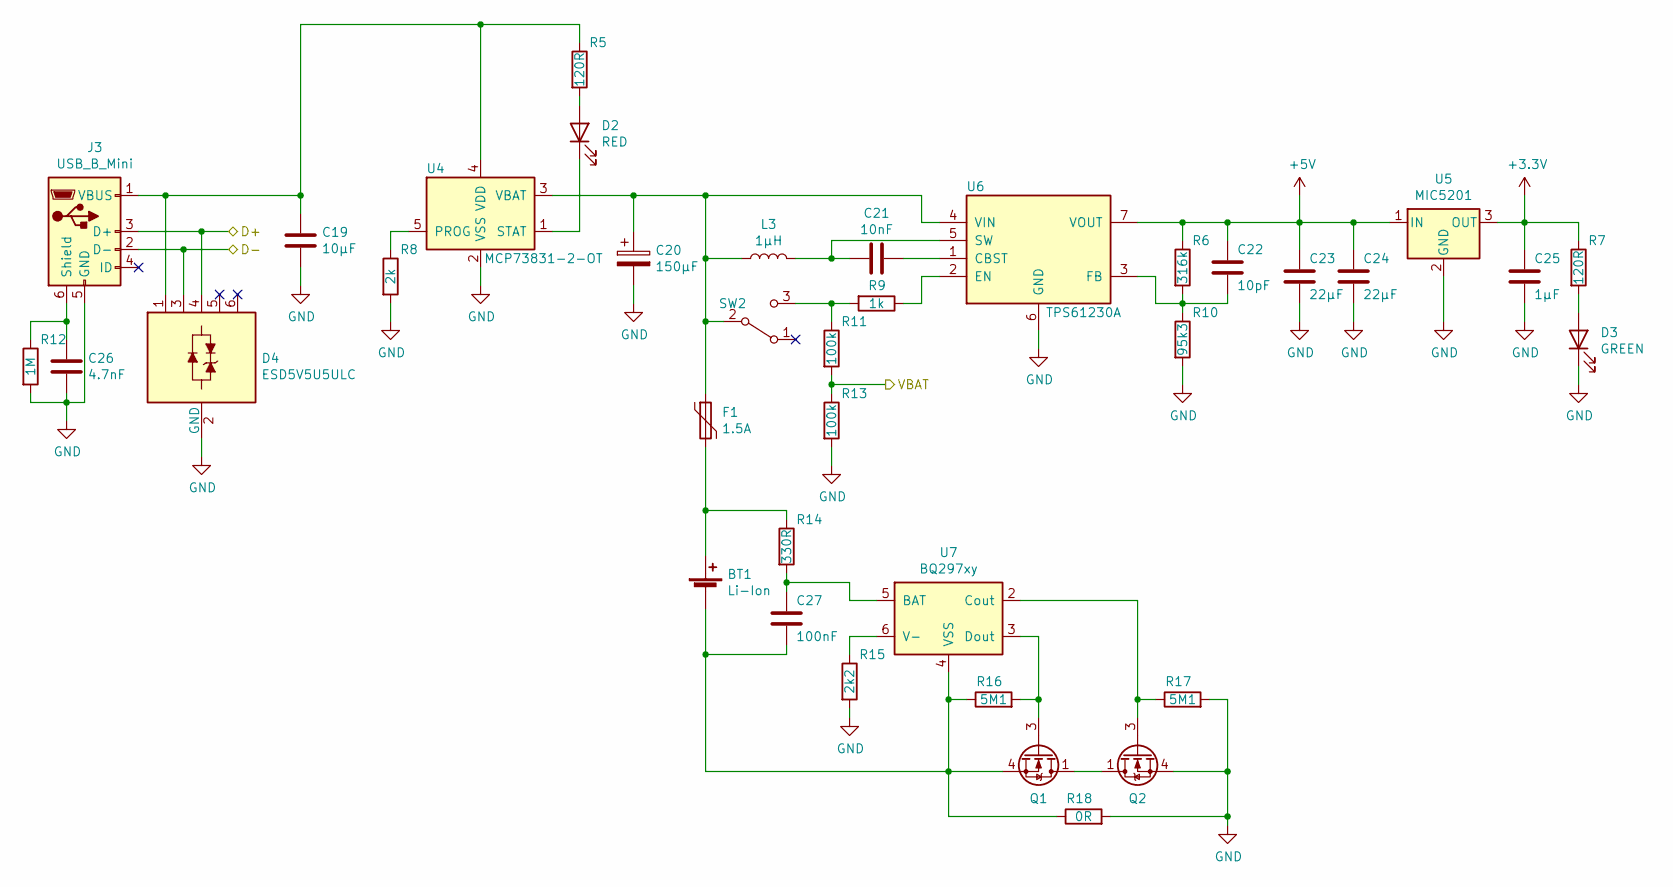
[picture p21: schematic power.sch]

Parts:
BT1: Li-Ion; 18650-holder
C19: 10µF; C_0805_2012Metric; Manufacturer Part Number CL21A106KOQNNNF
C20: 150µF; CP_EIA-7343-31_Kemet-D; Manufacturer Part Number T495D157K010ATE100
C21: 10nF; C_0805_2012Metric; Manufacturer Part Number C0805C103K1RAC7210
C22: 10pF; C_0805_2012Metric; Manufacturer Part Number C0805C100K5GACTU
C23, C24: 22µF; C_0805_2012Metric; Manufacturer Part Number GRM21BR61A226ME44L
C25: 1µF; C_0805_2012Metric; Manufacturer Part Number CL21B105KOFNNNG
C26: 4.7nF; C_0805_2012Metric; Manufacturer Part Number C0805C472K5RACTU
C27: 100nF; C_0805_2012Metric; Manufacturer Part Number C0805C104M3RAC7210
D2: RED; LED_0402_1005Metric; Manufacturer Part Number APHHS1005SURCK
D3: GREEN; LED_0402_1005Metric; Manufacturer Part Number APHHS1005ZGCK
D4: ESD5V5U5ULC; SOT-23-6; Manufacturer Part Number ESD5V5U5ULC E6327
F1: 1.5A; Fuse_1206_3216Metric_Castellated; Manufacturer Part Number 0ZCJ0150FF2C
J3: USB_B_Mini; USB_Mini-B_Wuerth_65100516121_Horizontal; Manufacturer Part Number 65100516121
L3: 1µH; L_Wuerth_MAPI-4020; Manufacturer Part Number 74438356010
Q1, Q2: CSD16301Q2; Texas_DQK; Manufacturer Part Number CSD16301Q2
R5, R7: 120R; R_0805_2012Metric; Manufacturer Part Number RC0805JR-07120RL
R6: 316k; R_0805_2012Metric; Manufacturer Part Number RC0805FR-07316KL
R8: 2k; R_0805_2012Metric; Manufacturer Part Number RC0805JR-072KL
R9: 1k; R_0805_2012Metric; Manufacturer Part Number RC0805JR-071KL
R10: 95k3; R_0805_2012Metric; Manufacturer Part Number RC0805FR-0795K3L
R11, R13: 100k; R_0805_2012Metric; Manufacturer Part Number RC0805FR-07100KL
R12: 1M; R_0805_2012Metric; Manufacturer Part Number RC0805JR-071ML
R14: 330R; R_0805_2012Metric; Manufacturer Part Number RC0805JR-07330RL
R15: 2k2; R_0805_2012Metric; Manufacturer Part Number RC0805JR-072K2L
R16, R17: 5M1; R_0805_2012Metric; Manufacturer Part Number RC0805JR-075M1L
R18: 0R; R_1206_3216Metric; Manufacturer Part Number ERJ-8GEY0R00V
SW2: SW_SPDT; SW_SPDT_PCM12; Manufacturer Part Number MSS3-V-T/R
U4: MCP73831-2-OT; SOT-23-5; Manufacturer Part Number MCP73831T-2ACI/OT
U5: MIC5201; SOT-223-3_TabPin2; Manufacturer Part Number MIC5201-3.3YS-TR
U6: TPS61230A; Manufacturer Part Number TPS61230ARNSR
U7: BQ297xy; WSON-6_1.5x1.5mm_P0.5mm; Manufacturer Part Number BQ29700DSER

Connections:
+3V3: C25.1, R7.1, U5.3 (OUT); also elsewhere on the board
+5V: C22.1, C23.1, C24.1, R6.1, U5.1 (IN), U6.7 (VOUT); also elsewhere on the board
/D+: D4.4, J3.3 (D+); also elsewhere on the board
/D-: D4.3, J3.2 (D-); also elsewhere on the board
/VBAT: R11.2, R13.1; also elsewhere on the board
GND: C19.2, C20.2, C23.2, C24.2, C25.2, C26.2, D3.1 (K), D4.2 (GND), J3.5 (GND), Q2.4 (S), Q2.7 (S), R8.2, R10.2, R12.2, R13.2, R15.2, R17.2, R18.2, U4.2 (VSS), U5.2 (GND), U6.6 (GND); also elsewhere on the board
unnamed: BT1.1 (+), F1.2, R14.1
unnamed: BT1.2 (-), C27.2, Q1.4 (S), Q1.7 (S), R16.1, R18.1, U7.4 (VSS)
unnamed: C19.1, D4.1, J3.1 (VBUS), R5.1, U4.4 (VDD)
unnamed: C20.1, F1.1, L3.1, SW2.2 (B), U4.3 (VBAT), U6.4 (VIN)
unnamed: C21.1, U6.1 (CBST)
unnamed: C21.2, L3.2, U6.5 (SW)
unnamed: C22.2, R6.2, R10.1, U6.3 (FB)
unnamed: C26.1, J3.6 (Shield), R12.1
unnamed: C27.1, R14.2, U7.5 (BAT)
unnamed: D2.1 (K), U4.1 (STAT)
unnamed: D2.2 (A), R5.2
unnamed: D3.2 (A), R7.2
unnamed: Q1.1 (D), Q1.2 (D), Q1.5 (D), Q1.6 (D), Q1.8 (D), Q2.1 (D), Q2.2 (D), Q2.5 (D), Q2.6 (D), Q2.8 (D)
unnamed: Q1.3 (G), R16.2, U7.3 (Dout)
unnamed: Q2.3 (G), R17.1, U7.2 (Cout)
unnamed: R8.1, U4.5 (PROG)
unnamed: R9.1, U6.2 (EN)
unnamed: R9.2, R11.1, SW2.3 (C)
unnamed: R15.1, U7.6 (V-)

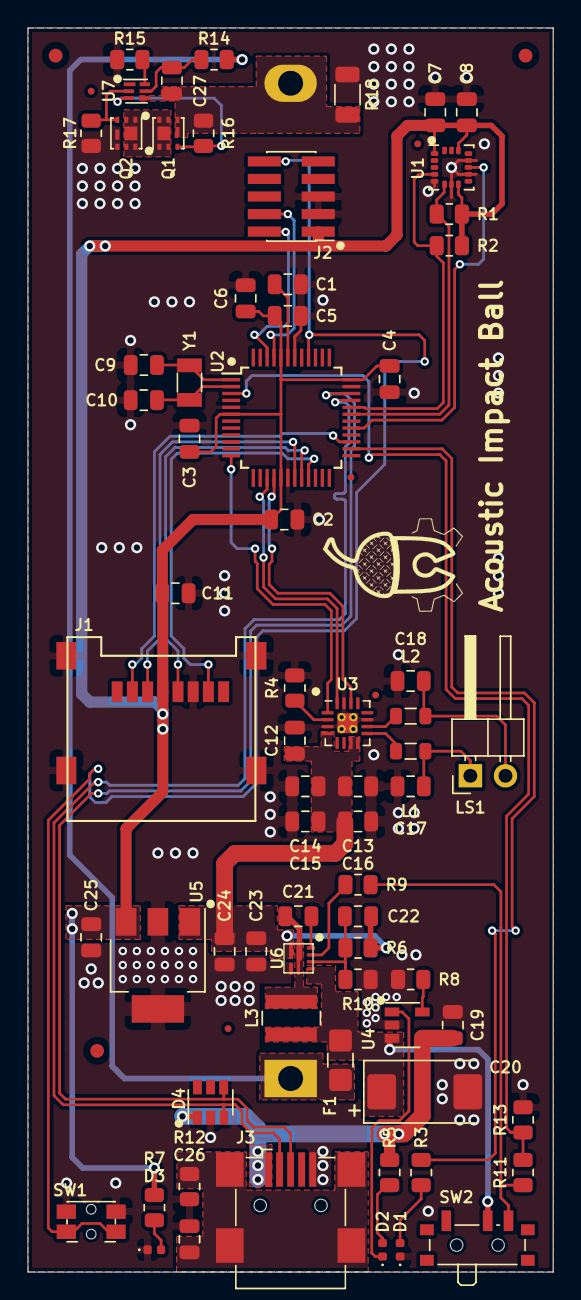
[picture p22: board acoustic-impact-ball.kicad_pcb from above]

Board: 2 copper layers, 38.0 x 90.0 mm, 70 parts (1 on the bottom side), 48 nets.
