akornsys-rdi/acoustic-impact-ball/src/test_flash/test_flash.ino

#include <SPI.h>
#include <SdFat.h>
#include <Adafruit_SPIFlash.h>
#include "ff.h"
#include "diskio.h"

#define DISK_LABEL    "EXT FLASH"

FATFS elmchamFatfs;
uint8_t workbuf[4096]; // Working buffer for f_fdisk function.

// On-board external flash (QSPI or SPI) macros should already
// defined in your board variant if supported
// - EXTERNAL_FLASH_USE_QSPI
// - EXTERNAL_FLASH_USE_CS/EXTERNAL_FLASH_USE_SPI
#if defined(EXTERNAL_FLASH_USE_QSPI)
  Adafruit_FlashTransport_QSPI flashTransport;

#elif defined(EXTERNAL_FLASH_USE_SPI)
  Adafruit_FlashTransport_SPI flashTransport(EXTERNAL_FLASH_USE_CS, EXTERNAL_FLASH_USE_SPI);

#else
  #error No QSPI/SPI flash are defined on your board variant.h !
#endif

Adafruit_SPIFlash flash(&flashTransport);

FatFileSystem fatfs;
  
void setup() {
  Serial.begin(115200);
  while (!Serial) delay(100);
  
  Serial.println("Adafruit SPI Flash FatFs Format Example");

  if (!flash.begin()) {
    Serial.println("Error, failed to initialize flash chip!");
    while(1) yield();
  }
  Serial.print("Flash chip JEDEC ID: 0x"); Serial.println(flash.getJEDECID(), HEX);
  Serial.print("Flash size: "); Serial.println(flash.size());

  Serial.setTimeout(30000);
  do {
    Serial.println("!!!!!!!!!!!!!!!!!!!!!!!!!!!!!!!!!!!!!!!!!!!!!!!!!!!!!!!!!!!!!!!!!!!!!");
    Serial.println("This sketch will ERASE ALL DATA on the flash chip and format it with a new filesystem!");
    Serial.println("Type OK (all caps) and press enter to continue.");
    Serial.println("!!!!!!!!!!!!!!!!!!!!!!!!!!!!!!!!!!!!!!!!!!!!!!!!!!!!!!!!!!!!!!!!!!!!!");
  } while ( !Serial.find("OK"));

  Serial.println("Creating and formatting FAT filesystem (this takes ~60 seconds)...");

  FRESULT r = f_mkfs("", FM_FAT | FM_SFD, 0, workbuf, sizeof(workbuf));
  if (r != FR_OK) {
    Serial.print("Error, f_mkfs failed with error code: "); Serial.println(r, DEC);
    while(1) yield();
  }

  r = f_mount(&elmchamFatfs, "0:", 1);
  if (r != FR_OK) {
    Serial.print("Error, f_mount failed with error code: "); Serial.println(r, DEC);
    while(1) yield();
  }

  Serial.println("Setting disk label to: " DISK_LABEL);
  r = f_setlabel(DISK_LABEL);
  if (r != FR_OK) {
    Serial.print("Error, f_setlabel failed with error code: "); Serial.println(r, DEC);
    while(1) yield();
  }

  f_unmount("0:");

  flash.syncBlocks();
  
  Serial.println("Formatted flash!");

  if (!fatfs.begin(&flash)) {
    Serial.println("Error, failed to mount newly formatted filesystem!");
    while(1) delay(1);
  }

  Serial.println("Flash chip successfully formatted with new empty filesystem!");
}

void loop() {

}


//--------------------------------------------------------------------+
// fatfs diskio
//--------------------------------------------------------------------+
extern "C"
{

DSTATUS disk_status ( BYTE pdrv )
{
  (void) pdrv;
	return 0;
}

DSTATUS disk_initialize ( BYTE pdrv )
{
  (void) pdrv;
	return 0;
}

DRESULT disk_read (
	BYTE pdrv,		/* Physical drive nmuber to identify the drive */
	BYTE *buff,		/* Data buffer to store read data */
	DWORD sector,	/* Start sector in LBA */
	UINT count		/* Number of sectors to read */
)
{
  (void) pdrv;
	return flash.readBlocks(sector, buff, count) ? RES_OK : RES_ERROR;
}

DRESULT disk_write (
	BYTE pdrv,			/* Physical drive nmuber to identify the drive */
	const BYTE *buff,	/* Data to be written */
	DWORD sector,		/* Start sector in LBA */
	UINT count			/* Number of sectors to write */
)
{
  (void) pdrv;
  return flash.writeBlocks(sector, buff, count) ? RES_OK : RES_ERROR;
}

DRESULT disk_ioctl (
	BYTE pdrv,		/* Physical drive nmuber (0..) */
	BYTE cmd,		/* Control code */
	void *buff		/* Buffer to send/receive control data */
)
{
  (void) pdrv;

  switch ( cmd )
  {
    case CTRL_SYNC:
      flash.syncBlocks();
      return RES_OK;

    case GET_SECTOR_COUNT:
      *((DWORD*) buff) = flash.size()/512;
      return RES_OK;

    case GET_SECTOR_SIZE:
      *((WORD*) buff) = 512;
      return RES_OK;

    case GET_BLOCK_SIZE:
      *((DWORD*) buff) = 8;    // erase block size in units of sector size
      return RES_OK;

    default:
      return RES_PARERR;
  }
}

}
