akornsys-rdi/acoustic-impact-ball/src/test_card/test_card.ino

#include <SPI.h>
#include <SD.h>

Sd2Card card;
SdVolume volume;
SdFile root;

const int chipSelect = 10;

void setup() {
  SerialUSB.begin(115200);
  while (!SerialUSB) {
  }


  SerialUSB.print("\nInitializing SD card...");

  if (!card.init(SPI_HALF_SPEED, chipSelect)) {
    SerialUSB.println("initialization failed. Things to check:");
    SerialUSB.println("* is a card inserted?");
    SerialUSB.println("* is your wiring correct?");
    SerialUSB.println("* did you change the chipSelect pin to match your shield or module?");
    while (1);
  } else {
    SerialUSB.println("Wiring is correct and a card is present.");
  }

  // print the type of card
  SerialUSB.println();
  SerialUSB.print("Card type:         ");
  switch (card.type()) {
    case SD_CARD_TYPE_SD1:
      SerialUSB.println("SD1");
      break;
    case SD_CARD_TYPE_SD2:
      SerialUSB.println("SD2");
      break;
    case SD_CARD_TYPE_SDHC:
      SerialUSB.println("SDHC");
      break;
    default:
      SerialUSB.println("Unknown");
  }

  // Now we will try to open the 'volume'/'partition' - it should be FAT16 or FAT32
  if (!volume.init(card)) {
    SerialUSB.println("Could not find FAT16/FAT32 partition.\nMake sure you've formatted the card");
    while (1);
  }

  SerialUSB.print("Clusters:          ");
  SerialUSB.println(volume.clusterCount());
  SerialUSB.print("Blocks x Cluster:  ");
  SerialUSB.println(volume.blocksPerCluster());

  SerialUSB.print("Total Blocks:      ");
  SerialUSB.println(volume.blocksPerCluster() * volume.clusterCount());
  SerialUSB.println();

  uint32_t volumesize;
  SerialUSB.print("Volume type is:    FAT");
  SerialUSB.println(volume.fatType(), DEC);

  volumesize = volume.blocksPerCluster();
  volumesize *= volume.clusterCount();
  volumesize /= 2;
  SerialUSB.print("Volume size (Kb):  ");
  SerialUSB.println(volumesize);
  SerialUSB.print("Volume size (Mb):  ");
  volumesize /= 1024;
  SerialUSB.println(volumesize);
  SerialUSB.print("Volume size (Gb):  ");
  SerialUSB.println((float)volumesize / 1024.0);

  SerialUSB.println("\nFiles found on the card (name, date and size in bytes): ");
  root.openRoot(volume);

  root.ls(LS_R | LS_DATE | LS_SIZE);
}

void loop(void) {
}
