akornsys-rdi/acoustic-impact-ball/(commit log)

2020-02-25 añadida pcb
    [acustic-impact-ball.kicad_pcb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]
2020-02-25 subido código de prototipo
2020-02-25 subido modelo 3d de prototipo
    [acustic-impact-ball.scad, acustic-impact-ball.stl]
2020-08-20 subido nuevo diseño 3d
    [acustic-impact-ball.scad, acustic-impact-ball.stl, lid.stl, ring.stl, switch-handler.stl]
2023-03-11 subido código de pruebas y producción
2023-03-11 actualizado 3d
    [acustic-impact-ball.scad, lid-test.stl]
2023-03-11 creado archivo de notas sobre el proyecto
2023-03-11 actualizada tapa 3D
    [acustic-impact-ball.scad]
2023-03-18 añadidos comentarios de versiones usadas y actualizados comentarios de funciones
2023-10-07 actualizada carcasa para nueva pcb, corregidos puntos debiles de version anterior, generados archivos numerados
    [acoustic-impact-ball.scad, acustic-impact-ball.scad, lid-test.stl, ring.stl, switch-fastening_inf.stl, switch-fastening_sup.stl, switch-handler.stl]
2023-10-07 rediseñada pcb y generados archivos de fabricacion
    [acoustic-impact-ball-all-pos.csv, acoustic-impact-ball-back.gbl, acoustic-impact-ball-bom+cpl.xls, acoustic-impact-ball-front.gtl, acoustic-impact-ball-mask-back.gbs, acoustic-impact-ball-mask-front.gts, acoustic-impact-ball-paste-back.gbp, acoustic-impact-ball-paste-front.gtp]
2023-10-07 eliminado archivo de notas de la anterior version
