akornsys-rdi/acoustic-impact-ball/(notices)

Notices in the files:
brd/acoustic-impact-ball.kicad_pcb:
Released under GNU/GPL 3 License
https://www.gnu.org/licenses/gpl.html
Copyright © 2023 RileyStarlight
